andrem20/HazMapper/Documentation/Report_HazMapper_PT.pdf

HazMapper: Robo de Mapeamento de ˆ | Areas ´

# Perigosas

Projeto Integrador 2, 3º ano, Licenciatura em Engenharia Eletronica e Computadores ´ Universidade do Minho, Escola de Engenharia

Autores
Alvaro Silva, A104948 ´
Ana Cruz, A104950
Andre Martins, A104944 ´
Mariana Martins, A104961

Orientador
Prof. Adriano Tavares

Abstract—A crescente complexidade e os riscos inerentes a diversos ambientes industriais e de desastre sublinham a ne-
cessidade premente de soluçoes aut ˜ | onomas e seguras para a ´
monitorizaçao e mapeamento de ˜ | areas perigosas. A exposiç ´ | aõ
humana a atmosferas toxicas, temperaturas extremas ou ´ | areas de ´
difícil acesso representa um desafio significativo para a segurança
ocupacional e a resposta a emergencias. Neste contexto, a rob ˆ | otica ´
movel surge como uma tecnologia habilitadora, oferecendo a ´ capacidade de coletar dados críticos sem colocar operadores em risco direto.
Este relatorio apresenta o HazMapper, um rob ´ | o aut ˆ | onomo ´
concebido para a avaliaçao de ambientes de risco. O HazMapper ˜ integra um conjunto de sensores para medir parametros ambien- ˆ
tais cruciais, como a concentraçao de di ˜ | oxido de carbono (CO ´ | 2)
e a temperatura, transmitindo os dados em tempo real para uma
estaçao de controlo remota. Para garantir a navegaç ˜ | ao segura, ˜
o robo disp ˆ | oe tamb ˜ | em de sensores de deteç ´ | ao de obst ˜ | aculos, ´
que impedem o avanço em direçoes bloqueadas, permitindo a ˜
movimentaçao apenas nas ˜ | areas desimpedidas. No caso de n ´ | aõ
ser possível visualizar o ambiente diretamente, a presença de uma
camara ˆ | onboard possibilita o acompanhamento visual remoto do
que esta a acontecer. A arquitetura do sistema baseia-se num ´ microcontrolador STM32H755ZIQ para processamento central e controlo de movimento, com locomoçao omnidirecional garantida ˜ por quatro rodas e motores independentes. A comunicaçaõ
sem fios e assegurada por um m ´ | odulo ´ | ESP, que estabelece
uma ligaçao Bluetooth Low Energy (BLE) com uma aplicaç ˜ | aõ
Android desenvolvida especificamente para controlo intuitivo via joystick virtual. Adicionalmente, o robo incorpora um sistema de ˆ
mediçao cont ˜ | ínua da tensao da bateria, essencial para a gest ˜ | aõ
da autonomia e fiabilidade operacional. Foi implementado um RTOS no sistema de modo a o tornar mais eficiente e rapidamente responsivo.

AGRADECIMENTOS

Agradecemos ao Andre Costa e ´ | a professora Sofia Paiva por `
todo o apoio e orientaçao ao longo da realizaç ˜ | ao do projeto. ˜
Agradecemos tambem ao professor V ´ | ítor Silva pela confiança
no nosso potencial. Por fim — e nao menos importante — ˜ agradecemos ao professor Adriano Tavares pela confiança depositada e por ter aceite o nosso pedido para ser nosso orientador.
I. ANALISE ´
A. Diagrama de Use-Case
Anexo X-A Figura 20
B. Diagrama de Blocos

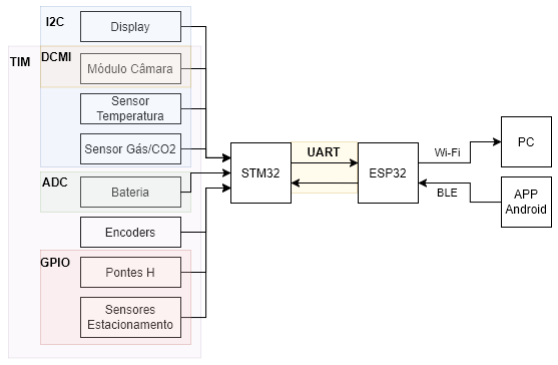
[picture p1: figure]

Fig. 1. Diagrama de Blocos Do Sistema

II. ARQUITETURA DE CONTROLO

A. Sistema de Movimentaçaõ
O HazMapper esta equipado com rodas omnidirecionais. ´ Estas possuem a capacidade de se movimentar livremente em qualquer direçao no plano horizontal, sem a necessidade de ˜ mudar a orientaçao do movimento. Este tipo de rodas oferece ˜ uma grande flexibilidade e agilidade, tornando-o muito util em ´
aplicaçoes que requerem movimentos precisos e r ˜ | apidos. ´
No nosso sistema, o movimento do robô e assegurado por ´ quatro motores, cada um acoplado a uma roda omnidirecional. O controlo individual de cada motor permite combinar os seus movimentos para produzir deslocamentos complexos, incluindo avanços, recuos e deslocamentos diagonais.
Cada motor e gerido de forma independente por uma ´ estrutura (motors_id) que agrega um conjunto de variaveis ´

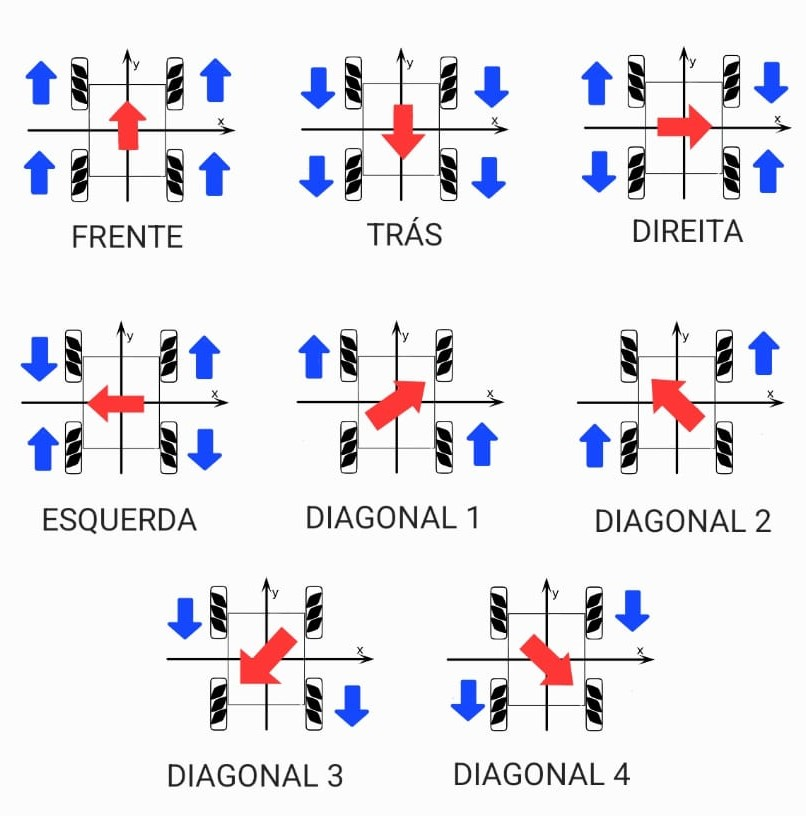
[picture p2: figure]

Fig. 2. Direçoes poss ˜ | íveis do robô

e estruturas necessarios para o seu controlo. As principais ´ características sao: ˜
- Estado: Indica se o motor esta parado (OFF), a andar ´ para a frente (FORWARD) ou para tras (REVERSE). ´
- Pinos | de | Direçao: ˜ | Dois | pinos | digitais
(FORWARD_DRIVE e REVERSE_DRIVE) controlam o
sentido de rotaçao. ˜
- PID Individual: Cada motor possui os seus proprios ´
parametros PID ( ˆ | Kp, Ki, Kd), permitindo afinaçao in- ˜
dependente.
- Variaveis de Execuç ´ | ao: ˜ | Incluem posiçao e velocidade ˜
(em rad/s e rpm), valor de PWM (modulaçao por largura ˜ de pulso) aplicado, e variaveis internas do controlo PID ´ (erro anterior, integral, etc.).
- Timer de PWM: Um TIM dedicado por motor e utilizado ´ para gerar o sinal PWM que regula a velocidade, que é aplicado ao pino ENABLE da ponte-H.
- Timer para Encoder: Cada motor utiliza um TIM em modo encoder (canais A e B) para leitura da posiçao e ˜ velocidade.
Esta estrutura modular permite o controlo preciso e independente de multiplos motores, facilitando a escalabilidade e ´ manutençao do sistema. ˜
A direçao de cada motor pode ser alterada ativando as ˜ entradas apropriadas do controlo da ponte H associada, como podemos ver nos Anexos X-B, permitindo movimento para a frente ou para tras, ou a paragem total. O verdadeiro desafio ´ no controlo de um robo com rodas omnidirecionais reside na ˆ coordenaçao dos quatro motores para alcançar o movimento ˜ global pretendido. Assim, o movimento do robô e gerido ´ com base numa LUT (Look-Up Table), onde estao definidos ˜ todos os movimentos possíveis (Figura 2) e a combinaçaõ correspondente de estados dos quatro motores, informaçao que ˜ foi retirada a partir da Figura 3. Esta LUT e consultada sempre ´ que e enviado um comando de movimento, permitindo uma ´
transiçao r ˜ | apida e organizada entre diferentes direç ´ | oes ˜
Quando um determinado comando e ativado, o sistema ´ atualiza os estados individuais dos motores de acordo com a entrada correspondente na LUT e posteriormente o PWM a

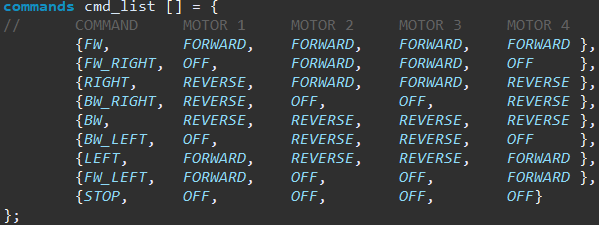
[picture p3: figure]

Fig. 3. LUT dos movimentos possíveis

eles aplicado. Estes estados sao traduzidos em sinais digitais ˜
que controlam os pinos de ativaçao das pontes H respons ˜ | aveis ´
por alimentar os motores.
O sistema e ainda capaz de ligar e desligar o rob ´ | o atrav ˆ | es de ´
um pino digital dedicado, garantindo que, quando desligado, todos os motores ficam inativos por segurança.
1) Algoritmo de Controlo de Velocidade – Controlo PID:
Para alem do controlo da direç ´ | ao, ˜ | e tamb ´ | em essencial que ´
todas as rodas girem a mesma velocidade, a fim de evitar `
desvios na trajetoria do rob ´ | o e assegurar uma locomoç ˆ | aõ
estavel e controlada.Para garantir o controlo preciso da ´ velocidade dos motores do robo, foi implementado um ˆ controlador PID (Proporcional-Integral-Derivativo) em malha fechada. Este tipo de controlo baseia-se na mediçao cont ˜ ínua da velocidade atual de cada motor e na comparaçao com um ˜
valor de referencia, designado por ˆ | setpoint. O objetivo do
controlador e minimizar o erro entre a velocidade medida ´ e a desejada, ajustando dinamicamente o sinal de controlo aplicado a cada motor.

A velocidade atual de cada motor e determinada utilizando ´ timers individuais dedicados a cada motor, configurados em modo encoder com suporte a codificaçao em quadratura. Cada ˜ motor possui um encoder incremental que gera dois sinais digitais, desfasados de 90°, permitindo contar pulsos e identificar a
direçao de rotaç ˜ | ao. Estes sinais s ˜ | ao ligados ˜ | as entradas de dois `
canais do timer. Esta funcionalidade permite que o contador interno do timer incremente ou decremente automaticamente
em funçao da do sentido de rotaç ˜ | ao e do n ˜ | umero de transiç ´ | oes ˜
dos sinais, sem necessidade de intervençao do processador, ˜ atualizando o valor do contador (TIMx_CNT) conforme o movimento do eixo, o que e crucial para o controlo bidire- ´ cional dos motores.
A variaçao de posiç ˜ | ao entre duas amostragens sucessivas ˜ | é
calculada subtraindo o valor anterior da posiçao ao valor atual. ˜
A posiçao atual do eixo do motor ˜ | e obtida atrav ´ | es da ´
leitura do valor do contador do timer, utilizando a macro
__HAL_TIM_GET_COUNTER(), e corresponde a posiç ` | aõ
absoluta acumulada desde o início do movimento. Com base
na posiçao acumulada, calcula-se a posiç ˜ | ao angular em graus, ˜
utilizando a seguinte expressao: ˜

θgraus =

posiçaõ × 360
PULSOS × 4 × SAMPLING TIME

(1)

A velocidade angular e calculada a partir da variaç ´ | aõ

do numero de pulsos entre duas mediç ´ | oes consecutivas. ˜
Assume-se um período de amostragem constante, e os fatores
numericos utilizados nas express ´ | oes abaixo incorporam esse ˜
intervalo de tempo. A formula utilizada para o c ´ | alculo da ´
velocidade em rad/s e:´

ω =

∆pulsos × 2π
PULSOS × 4 × SAMPLING TIME
(rad/s) | (2)
Cada transiçao nos sinais A e B (subida e descida) ˜ | | é
contabilizada, resultando numa multiplicaçao por quatro da ˜
resoluçao efetiva — da ˜ | í a utilizaçao de um fator de ˜ | 4 nos
calculos que envolvem o n ´ | umero de pulsos por volta ( ´ | pulses
per revolution, ou PPR). Estes calculos permitem obter, com ´
elevada precisao, a posiç ˜ | ao e a velocidade angular do motor, ˜
tirando partido da contagem automatica dos pulsos em modo ´ quadratura.
O erro de controlo e calculado como a diferença entre o ´ setpoint e a velocidade medida y:
| erro = setpoint − y | (3)

O controlador PID calcula o sinal de controlo como uma
combinaçao de tr ˜ | es componentes: ˆ
- Componente Proporcional (P): responde proporcionalmente ao erro atual, fornecendo uma correçao imediata; ˜
- Componente Integral (I): acumula o erro ao longo do tempo, eliminando desvios persistentes;
- Componente Derivativo (D): atua sobre a taxa de
variaçao do erro, ajudando a reduzir oscilaç ˜ | oes e ante- ˜
cipar tendencias. ˆ
Matematicamente, a saída do controlador e dada por: ´

output[k] = Kpe[k] + Ki

Pk
i=1

e[i]+e[i−1]
2

h + Kd

e[k]−e[k−1]
h
(4)
Na implementaçao pr ˜ | atica, este c ´ | alculo ´ | e discretizado e re- ´
alizado a cada período de amostragem. A saída do controlador
e utilizada para ajustar o ´ | duty cycle do sinal PWM aplicado a
cada motor, controlando assim a sua velocidade. Para garantir a segurança do sistema e respeitar os limites físicos, esta saída
e limitada entre 0 e a tens ´ | ao m ˜ | axima fornecida pela bateria. No ´
sistema implementado, a unica forma de controlar a velociade ´
e atrav ´ | es da definiç ´ | ao do ˜ | setpoint.
A eficacia deste tipo de controlo depende fortemente da ´
sintonizaçao adequada dos par ˜ | ametros do PID ˆ | , nomeada-
mente os ganhos proporcional (Kp), integral (Ki) e derivativo (Kd). Um ganho proporcional demasiado elevado pode induzir oscilaçoes; um ganho integral incorretamente calibrado pode ˜ provocar acumulaçao de erro e instabilidade; e um ganho ˜ derivativo excessivo pode amplificar o ruído proveniente da mediçao da velocidade. ˜
Uma analise mais detalhada do processo de determinaç ´ | aõ
dos parametros do PID ser ˆ | a apresentada na Subsecç ´ | ao VI, ˜
onde se descrevem os testes realizados e os criterios utilizados ´ para alcançar uma resposta estavel e eficaz. ´

Este controlo em malha fechada (Figura 21) permite uma
regulaçao robusta e eficiente da locomoç ˜ | ao do rob ˜ | o, mesmo ˆ
perante perturbaçoes externas, variaç ˜ | oes de carga ou assime- ˜
trias entre motores.
B. Interface de Comando via Aplicaçao M ˜ | ovel ´
A interaçao com o rob ˜ | o HazMapper ˆ | e realizada atrav ´ | es´
de uma aplicaçao m ˜ | ovel () desenvolvida para a plataforma ´
Android, utilizando a linguagem Kotlin. Esta aplicaçao serve ˜ como a interface principal de controlo e futura monitorizaçao, ˜ oferecendo uma experiencia de utilizador intuitiva para a ˆ
operaçao remota do rob ˜ | o.ˆ
1) Protocolo de Comunicaçao e Otimizaç ˜ | ao BLE: ˜ | A
comunicaçao com o m ˜ | odulo ´ | ESP do robô e realizada via ´
Bluetooth Low Energy (BLE), utilizando um protocolo
binario de dois bytes ´ | . O primeiro byte define o tipo de
comando (ex: 0x00 para ON/OFF, 0x01 para Direçao, ˜ | 0x02
para Velocidade), e o segundo byte especifica o valor associ-
ado. A estrutura completa desta gramatica de comunicaç ´ | aõ
e detalhada na Figura 4. Para otimizar o tr ´ | afego BLE, os ´
comandos de movimento sao enviados apenas quando os seus ˜ valores atuais diferem dos ultimos transmitidos. ´

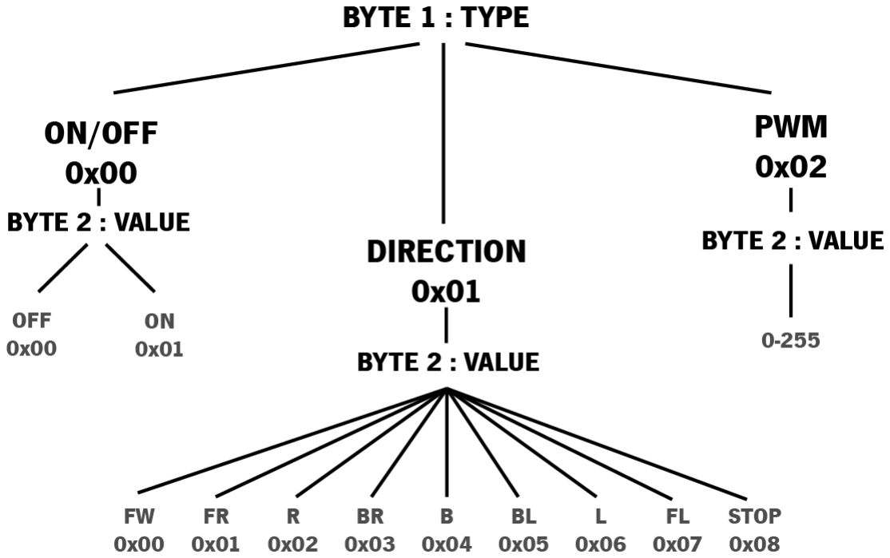
[picture p4: figure]

Fig. 4. Gramatica - comandos ´

2) Funcionalidades da Interface: A interface de utilizador inclui um Switch ON/OFF e um Joystick Virtual:
- O Switch ON/OFF controla o estado operacional do
robo. Ao ligar, envia um comando ( ˆ | 0x00, 0x01). Ao
desligar, alem do comando ( ´ | | 0x00, 0x00), a aplicaçaõ
envia comandos de STOP (0x01, 0x08) e velocidade zero (0x02, 0x00), garantindo a imobilizaçao imedi- ˜ ata.
- O Joystick Virtual (JoystickView) permite controlo omnidirecional, traduzindo a posiçao do ”handle” em co- ˜ mandos de direçao e velocidade, enviados a cada 500ms. ˜
– Direçao: ˜ | A posiçao angular ˜ | e quantificada em 8 ´
direçoes discretas (ex: ˜ | | FW, LEFT) ou STOP (na
deadzone central), enviadas como tipo 0x01.
– Velocidade: A distancia do ”handle” ao centro ˆ | e nor- ´
malizada de 0 (parado) a 255 (maximo), transmitida ´ como tipo 0x02. Uma histerese de 20 unidades é aplicada para estabilidade.

3) Conectividade: A aplicaçao gere as permiss ˜ | oes Blue- ˜
tooth necessarias (incluindo as espec ´ | | íficas do Android 12+) e
utiliza uma classe auxiliar (BLEManager) para a inicializaçaõ
e gestao da conex ˜ | ao BLE, assegurando uma comunicaç ˜ | aõ
fiavel com o rob ´ | o.ˆ

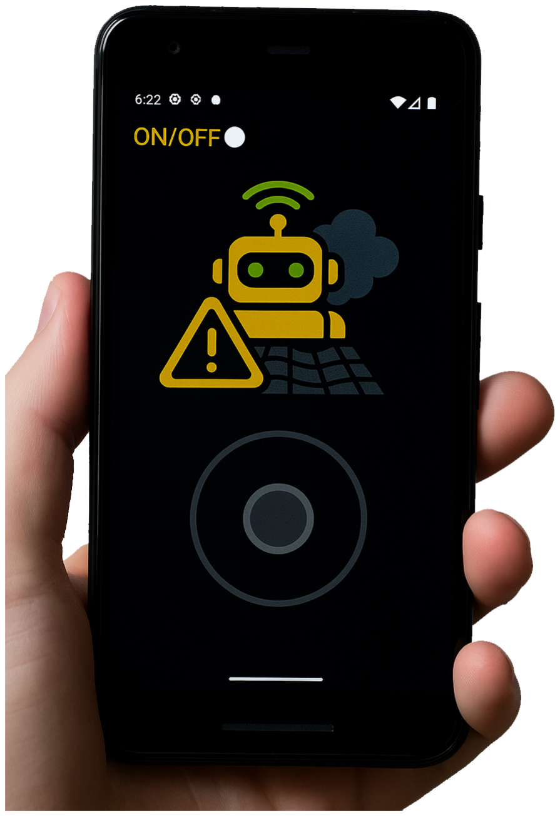
[picture p5: figure]

Fig. 5. App - Android

C. Comunicaçao Bluetooth via ˜ | ESP
Neste contexto, a ESP atua como um intermediario entre a ´
aplicaçao Android e a ˜ | STM32H755 utilizada, fazendo buffer-
ing dos dados recebidos via Bluetooth, transmitindo-os à STM atraves da UART. ´
Uma vez que e importante ter em consideraç ´ | ao os recursos ˜
do microcontrolador, foi implementado o Bluetooth Low Energy em vez do Bluetooth Classic, embora sejam introduzidas
restriçoes a n ˜ | ível do throughput. A implementaçao do BLE ˜
foi feita recorrendo ao NimBLE, uma stack Bluetooth 5.4 open-source da Apache. Na ESP implementou-se um servidor Generic Attribute Profile (GATT) com característica de escrita, permitindo ao cliente GATT (aplicaçao Android) ˜
escrever nesse topico. Entre os dois dispositivos existe ´ | pairing,
sem bonding. De modo a garantir que nao h ˜ | a perda de dados ´
foram realizadas as seguinte consideraçoes. ˜
- Maximo payload (ATT) ´ | com Data Length Extension
(DLE): 251B
- Isso equivale a: 251
2 = 125 frames de 2B por pacote BLE
- Considerando um maximo de 6 pacotes por evento de ´ conexao (limite da pilha NimBLE): ˜

6 × 125 = 750 frames por evento

- Com eventos a cada 15ms, temos aproximadamente: 1 s
15 ms

= 66,66 ≈ 66 eventos por segundo

- Frames por segundo:

66 × 750 = 49500 frames por segundo

- Cada frame com 2 bytes:

49500 × 2 = 99000 bytes/segundo = 792000 bps

- Portanto, para suportar essa taxa via UART, a baud rate mínima precisa de ser:

≥ 792000bps

Deste modo, a UART foi implementada com uma baud rate de 1 Mbps e com um buffer de 1024 bytes.

III. SISTEMA DE SENSORIZAÇ AO PARA ˜ | DETEÇ AO DE ˜

RISCOS

A. Sensores de deteçao de obst ˜ | aculos ´
Com o intuito de tornar o robo sens ˆ | ível ao meio que o
rodeia implementamos sensores de ultrassom para deteçao de ˜
obstaculos. Tendo em perspetiva a realizaç ´ | ao do mapeamento ˜
do meio pretendíamos ter sensores que conseguiam reconhecer
obstaculos existentes a uma dist ´ | ancia consider ˆ | avel (superior a ´
0.5m). Como tal, implementamos sensores de estacionamento
para automoveis no rob ´ | o.ˆ
Deste modo, foi necessario compreender o funcionamento ´ dos sensores e como eles reconheciam e interpretavam as
distancias detetadas. Estes s ˆ | ao acoplados a um componente ˜
central que suporta ate 8 sensores e que envia dados para um ´
pequeno display. Apos uma primeira observaç ´ | | ao, obteve-se a ˜
onda da Fig.6.

Fig. 6. Onda Total dos sensores de ultrassom

Apos alguns testes, apercebemo-nos que a onda enviada ´ se divide um 3 partes: Start Bit, Sync Bit e 8 bytes de
informaçao (1 byte por sensor). Para al ˜ | em disso, reparamos, ´
tambem, que o valor enviado nesses bytes era diretamente ´
proporcional a dist ` | ancia detetada em cent ˆ | ímetros, com uma
razao de proporcionalidade de 10, tal como apresenta a tabela ˜ I.
Distancia Detetada ˆ | Valor Enviado (decimal)
d < 0.3 m | 0
0.3 m ≤ d < 0.4 m | 3
0.4 m ≤ d < 0.5 m | 4
0.5 m ≤ d < 0.6 m | 5
0.6 m ≤ d < 0.7 m | 6
0.7 m ≤ d < 0.8 m | 7
0.8 m ≤ d < 0.9 m | 8
0.9 m ≤ d < 1 m | 9
1.0 m ≤ d < 1.1 m | 10
1.1 m ≤ d < 1.2 m | 11
1.2 m ≤ d < 1.3 m | 12
1.3 m ≤ d < 1.4 m | 13
1.4 m ≤ d < 1.5 m | 14
d ≥ 1.5 m | 255
TABLE I
DISTANCIA DETETADA E RESPETIVO VALOR ENVIADO ˆ

Uma analise mais detalhada ao funcionamento das ondas ´ dos sensores encontra-se no anexo ??.

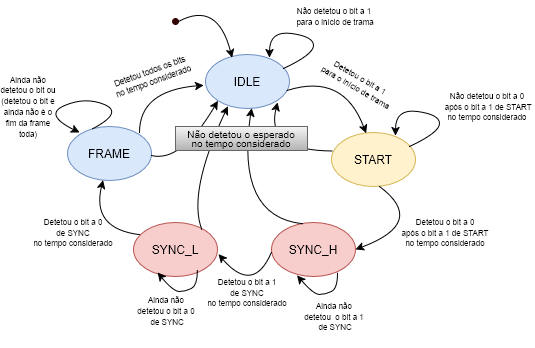
[picture p6: figure]

Fig. 7. Maquina de Estados implementada para os Sensores de Obst ´ | aculos ´

Conhecendo o princípio de funcionamento dos sensores,
implementamos um m ´ | etodo de descodificaç ´ | ao baseado na ˜
amostragem do sinal enviado, com um período de aquisiçaõ de 10 µs. O processo de descodificaçao e tratamento da trama ˜
recebida e implementado atrav ´ | es de uma m ´ | aquina de estados ´
finita (FSM), conforme ilustrado na Figura 7. Este sistema realiza a leitura sequencial dos bits recebidos, a validaçao por ˜
comparaçao com os padr ˜ | oes esperados para cada secç ˜ | ao da ˜
trama e o tratamento adequado conforme o estado atual do
processo. A cada condiçao da FSM acrescenta o a verificaç ˜ | aõ
de se foram lidos valores ou nao. Caso n ˜ | ao tenham sido, volta ˜
novamente para o estado onde se encontra.
B. Camara de Monitorizaç ˆ | ao para Zonas de Risco ˜
De forma a tornar o robo aplic ˆ | avel ´ | a situaç ` | ao apresentada, ˜
alem de dispor de controlo remoto para monitorizar zonas ´ perigosas, foi essencial dota-lo com a capacidade de trans- ´
missao de v ˜ | ídeo em tempo real, sendo assim implementado
o modulo OV7670, uma c ´ | amara que utiliza o protocolo ˆ
SCCB, compatível com I2C, para comunicar com a STM32.
Esta comunicaçaõ e realizada de forma ass ´ | íncrona, atraves´
de um barramento diferente dos outros sensores, pois neste
modulo n ´ | ao se encontram integradas as resist ˜ | encias ˆ | pull-up
características do barramento I2C.
A STM32 configura inicialmente a camara para capturar ˆ imagens com resoluçao QVGA (320×240 pixels), em modo ˜ RGB565 e vídeo progressivo. O funcionamento da camara ˆ assenta em sinais como o MCLK (clock mestre fornecido pela STM32 a c ` amara- 16 MHz), PCLK (clock de pixel ˆ que sincroniza a saída de dados), HSYNC (sincronizaçaõ horizontal que indica o início e fim de cada linha) e VSYNC
(sincronizaçao vertical que indica o in ˜ | ício e fim de cada
frame).
Cada frame contem 76 800 pixels, e com 16 bits por pixel, ´ totaliza 153 600 bytes por frame. Para captar estes dados, o microcontrolador STM32 recorre ao periferico DCMI (Digital ´ Camera Memory Interface), que recebe os dados da camara em ˆ modo de 8 bits por ciclo de PCLK. O DCMI esta configurado ´ para trabalhar em conjunto com o DMA, que transfere os dados recebidos diretamente para um buffer na memoria RAM, ´ evitando a intervençao cont ˜ ínua do CPU. Apos a captura de ´
um frame completo (HAL_DCMI_FrameEventCallback),
o conteudo do buffer ´ | e transmitido pela UART3 configurada ´
a uma baud rate elevada (2 Mbps), para permitir uma trans-
ferencia r ˆ | apida dos dados para o computador. A transmiss ´ | aõ
e realizada tamb ´ | em por DMA, assegurando que o microcon- ´
trolador nao fica bloqueado e pode continuar a capturar novos ˜ frames ou executar outras tarefas.
No computador, um script em Pyhton recolhe os dados
enviados pela UART, reconstroi os frames a partir da sequ ´ | encia ˆ
de bytes e exibe o vídeo capturado em tempo real, permitindo a visualizaçao do ambiente envolvente. ˜
Devido as limitaç ` | oes da aplicaç ˜ | ao embebida utilizada no ˜
que diz respeito ao suporte de perifericos multim ´ | edia, n ´ | aõ
foi possível obter um streaming de vídeo contínuo. Como alternativa, conseguimos apenas visualizar imagens de forma intervalada, ainda que com um atraso reduzido. A limitaçao da ˜ plataforma STM32, especialmente no processamento e trans-
missao eficiente de dados de imagem, impede a implementaç ˜ | aõ
de uma camara verdadeiramente ˆ | on board, obrigando a sua `
ligaçao ao computador via cabo USB. ˜
Apesar da adoçao de mecanismos para melhorar o desem- ˜ penho, como o aumento da baud rate e a utilizaçao de ˜ DMA (Direct Memory Access), o sistema continua sem capacidade
suficiente para suportar uma transmissao fluida. Consider ˜ | amos ´
ainda a implementaçao de compress ˜ | ao JPEG para comprimir ˜
os dados transferidos, mas essa abordagem, embora beneficie a largura de banda, nao resolve por completo o problema da ˜ velocidade de aquisiçao e envio. ˜
Adicionalmente, o uso do modo RGB565, embora eficiente em termos de profundidade de cor e compatibilidade com a maioria dos sensores, requer dois ciclos de clock para a transmissao de cada pixel, o que contribui ainda mais para a ˜ latencia do sistema e agrava a dificuldade de alcançar uma ˆ taxa de atualizaçao pr ˜ oxima do tempo real. ´
C. Monitorizaçao da Temperatura ˜
A monitorizaçao da temperatura do meio ambiente ˜ | e cr ´ | ítico
para a avaliaçao de riscos do HazMapper. Para isso, utilizamos ˜ um sensor de temperatura digital (HDC1080) com interface
I2C. A comunicaçaõ | e gerenciada pela ´ | STM32 atraves de ´
uma Maquina de Estados Finita (FSM - representada na Fig.8) ´ assíncrona, garantindo que as operaçoes de leitura do sensor ˜
nao bloqueiem outras funcionalidades do rob ˜ | o.ˆ
A FSM e composta por quatro estados principais que ´
coordenam a aquisiçao de dados de temperatura de forma n ˜ | ao- ˜
bloqueante:
- SENSOR STATE IDLE: Estado inicial, onde o sistema aguarda um sinal para iniciar uma nova mediçao. ˜
- SENSOR STATE TEMP TX: | Transmite-se | o
comando de leitura de temperatura ao HDC1080
via I2C.A transiçao para o pr ˜ | oximo estado ocorre ap ´ | os´
a conclusao da transmiss ˜ | ao. ˜

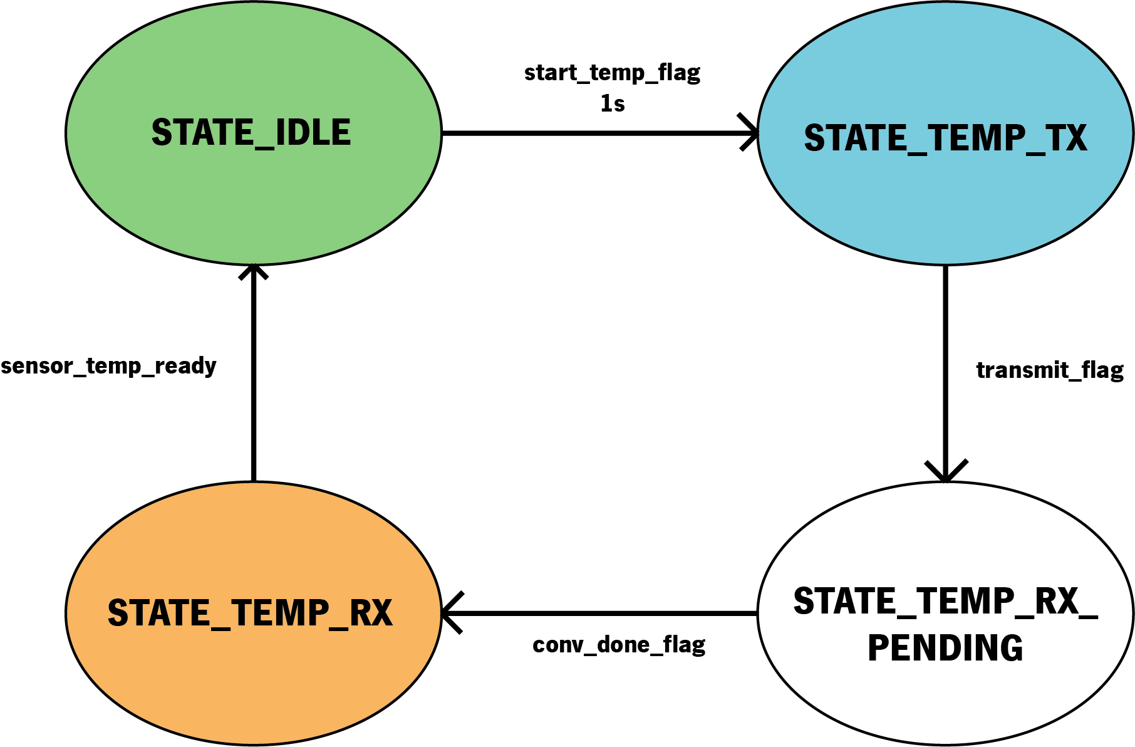
[picture p7: figure]

Fig. 8. Maquina de Estados - leitura do sensor HDC1080 ´

- SENSOR STATE TEMP RX PENDING: | Apos | a ´
transmissao, o sistema aguarda o tempo de convers ˜ | aõ
interna do sensor (15ms para o HDC1080).
- SENSOR STATE TEMP RX: Os 2 bytes de dados de temperatura sao lidos do HDC1080 via I2C Uma vez ˜ recebidos os dados brutos sao processados e convertidos ˜ para o valor em Celsius utilizando a formula: ´
Tcelsius = ((raw/65536.0f) ∗ 165.0) − 40.0.
D. Monitorizaçao dos n ˜ | íveis de gas´
A monitorizaçao dos gases em redor do HazMapper ˜ | é
uma componente essencial para garantir uma vigilancia eficaz ˆ das areas de risco. Para tal, foi integrado o sensor digital ´
CCS811, responsavel por medir a concentraç ´ | ao de di ˜ | oxido ´
de carbono equivalente (eCO) e compostos organicos vol ˆ | ateis ´
totais (TVOC) atraves de comunicaç ´ | ao I2C. ˜
A estrutura de programaçao deste sensor segue o mesmo ˜ princípio aplicado ao sensor de temperatura: foi implementada
uma maquina de estados ass ´ | íncrona.
Num primeiro momento, o sensor e configurado atrav ´ | es da ´
funçaõ ccs811_init na qual configuramos o pino WAKE de modo a que esteja a low para aceitar comandos I2C e configuramos a transiçao do boot mode para o application ˜ mode. Para isso, e enviado um comando especial, o byte 0xF4, ´ designado pelo fabricante como APP_START. Este comando
nao corresponde ˜ | a escrita num registo espec ` | ífico, mas sim a
uma instruçao direta que ordena ao CCS811 que inicialize o ˜ firmware interno de mediçao de gases, ficando pronto para ˜
fornecer dados de qualidade do ar. Apos esta inicializaç ´ | ao, ˜
o registo de modo de funcionamento MEAS_MODE e tamb ´ | em´
configurado para definir a frequencia de amostragem e eventu- ˆ
ais interrupçoes. A partir da ˜ | í, toda a leitura de dados e gerida ´
pela maquina de estados, que coordena a sequ ´ | encia ”pedido ˆ
de leitura → espera de conversaõ | → receçao dos dados”, ˜
garantindo que a comunicaçao I2C decorre de forma fi ˜ | avel ´
e sem conflitos.
Apos esta inicializaç ´ | ao, aproveitou-se a configuraç ˜ | ao do ˜
temporizador ja utilizada para o sensor de temperatura, apli- ´ cando uma estrutura semelhante para que o CCS811 tambem´
realizasse mediçoes com uma frequ ˜ | encia de 1 segundo. ˆ
Atraves da funç ´ | aõ start_read, e enviado o endereço do ´
registo 0x02, que corresponde ao bloco de dados de mediçao. ˜ Em seguida, o receive armazena o conteudo num array de 8 ´

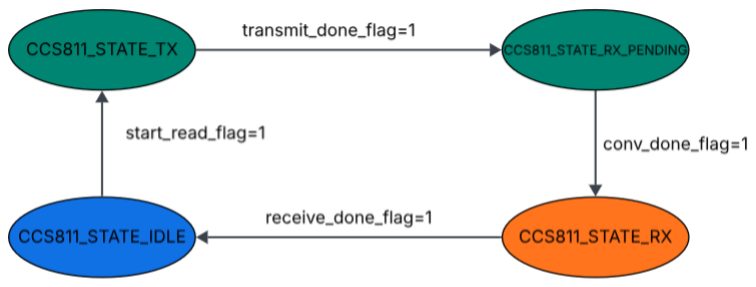
[picture p8: figure]

Fig. 9. Maquina de estados- leitura do sensor CCS811 ´

bytes, onde os primeiros dois bytes contem o valor de CO ˆ equivalente (eCO), o terceiro e quarto bytes contem o valor ˆ de TVOC e os restantes incluem informaçao adicional, como ˜ o estado do registo STATUS.
A maquina de estados ´ | e composta por quatro estados ´
principais:
- CCS811 STATE IDLE: Estado inicial, no qual o sistema permanece em espera e, ciclicamente, verifica se é
necessario iniciar a leitura do registo ´ | 0x02 do sensor.
- CCS811 STATE TX: Estado de transmissao, onde o ˜
endereço do registo 0x02 e enviado ao sensor. Ap ´ | os´
esta transmissao, ˜ | e introduzido um tempo de espera de ´
aproximadamente 5 ms para garantir a disponibilidade dos dados.
- CCS811 STATE RX PENDING: Decorrido o tempo de espera, o sistema inicia a receçao dos 8 bytes de dados ˜ provenientes do registo 0x02. A informaçao recebida ˜ inclui, em particular, os valores de CO2 e TVOC.
- CCS811 STATE RX: Estado final da leitura, em que os 4 bytes de interesse (do CO2 e TVOC) ja foram ´ processados. Neste ponto, e ativada uma flag para indicar ´ que a receçao terminou com sucesso. ˜
Apos esta etapa, foi implementado um c ´ | odigo para controlar ´
um display LCD 1602A, com o objetivo de apresentar, em tempo real, os valores medidos dos gases: o CO em ppm e o TVOC em ppb. Desta forma, tornou-se possível visualizar diretamente, no display, os dados adquiridos pelo sensor CCS811.
E. Monitorizaçao da bateria ˜
A constante avaliaçao da tens ˜ | ao da bateria ˜ | e crucial para a ´
autonomia e gestao de energia do rob ˜ | o, permitindo o ajuste ˆ
do controlo de velocidade dos motores e alertas sobre níveis
críticos. Este processo e implementado utilizando o ´ | Conversor
Analogico-Digital (ADC) ´ | da propria ´ | STM32.
A tensao da bateria ˜ | e, primeiramente, reduzida por um ´
divisor de resistivo (R1 = 50kΩ, R2 = 10kΩ) para ser compatível com a faixa de entrada do ADC (suporta ate 3.3V). ´ O valor digital de 12 bits (raw value) obtido pelo ADC é
entao convertido para Volts (V) atrav ˜ | es da seguinte f ´ | ormula: ´

VBAT = raw value ×

VREF
ADCMAX

×

R1 + R2
R2

(5)

Onde VREF = 2.0 V e ADCMAX = 4095.

A aquisiçao dos dados do ADC ˜ | e realizada de forma ´
periodica a cada 1ms, com a convers ´ | ao iniciada via ˜ | Direct
Memory Access (DMA) (HAL_ADC_Start_DMA), minimizando a carga no CPU. A funçaõ Battery_process() interpreta a leitura da tensao ( ˜ vbat) e, com base num limiar de 11.0V, ativa LEDs indicadores (laranja para bateria OK, vermelho para bateria crítica), alertando o utilizador sobre o estado de carga.
F. Transmissao de Dados de Sensores via Wi-Fi com ˜ | ESP
A transmissao dos dados via Wi-Fi com a ˜ | ESP visa con-
ferir uma monitorizaçao cuidada do sistema, bem como do ˜ ambiente que o rodeia.
Para tal, configurou-se a ESP como Access Point (AP). Um dispositivo (o computador, por exemplo) conecta-se a essa rede Wi-Fi e, apos estar corretamente configurado. pode ´
receber/enviar dados a partir dessa conexao, quer atrav ˜ | es´
de um servidor HTTP (Modelo OSI: HTPP - camada de Aplicaçao, baseado em TCP/IP - camada de transporte), quer ˜
atraves de sockets UDP. Como o envio das dados ´ | e frequente, ´
a perda de algum dado naõ e necessariamente cr ´ | ítica, e, como
tal, recorremos ao envio de sockets UDP para os dados dos
sensores. Para alem disso, por n ´ | ao requerer confirmaç ˜ | ao, o ˜
UDP introduz menor overhead.
IV. INTEGRAÇ AO DO ˜ | RTOS

A implementaçao de um Sistema Operativo de Tempo Real ˜ (RTOS) no sistema visou otimizar a eficiencia computacional ˆ e o desempenho global, assegurando:
- Comportamento determinístico;
- Baixa latencia ˆ ;
- Jitter controlado.
Para tal, adotou-se o FreeRTOS, aproveitando os seus mecanismos avançados de:
- Comunicaçao entre processos (IPC); ˜
- Escalonamento de tarefas por prioridades;
- Gestao de mem ˜ | oria est ´ | atica. ´
V. ESTRUTURA DE HARDWARE INTEGRADO EM PCB
Para este projeto, decidimos desenvolver uma PCB personalizada com o objetivo de minimizar a utilizaçao de fios e ˜
reduzir interferencias eletromagn ˆ | eticas. A PCB foi projetada ´
em duas secçoes principais: uma de pot ˜ | encia e outra de sinais ˆ
digitais.
Entre estas duas zonas, foi criada uma area de isolamento, ´ onde se encontram os isoladores capacitivos, como podemos
ver na Figura 10. Estes sao respons ˜ | aveis por garantir o ´
isolamento galvanico entre os sinais de pot ˆ | encia e os sinais ˆ
digitais, especialmente nos casos em que sinais de potencia ˆ precisam ser lidos pela STM32 ou vice-versa. Para o canal ADC, foi utilizado um isolador analogico juntamente com um ´ díodo Zener de 3,3V para proteger o pino da STM32 contra sobretensoes. ˜
De forma a garantir o isolamento total entre os domínios de
potencia e digital, tamb ˆ | em foi utilizado um conversor DC-DC ´
isolado e regulado para alimentar a STM32. Certificamo-nos ´

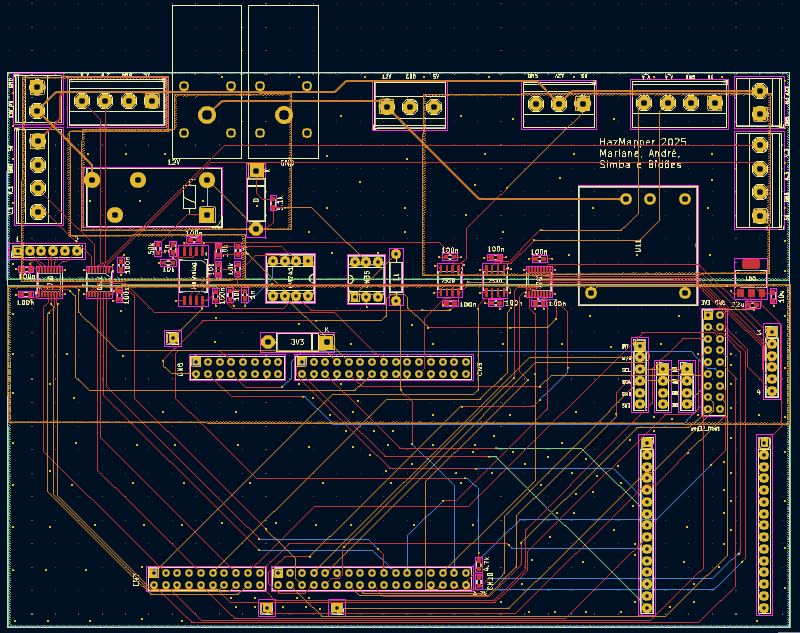
[picture p9: figure]

Fig. 10. Layout da PCB

ainda de que todos os sinais partilhados entre os dois domínios estavam devidamente isolados. Como os pinos da STM32 fornecem, em media, apenas 25 mA de corrente, decidiu-se ´ utilizar um regulador LDO (de 5 V para 3,3 V) dedicado. Esta soluçao garante que os sensores e demais componentes que ˜
necessitam de alimentaçao a 3,3 V n ˜ | ao sejam alimentados ˜
diretamente pela STM32, a qual nao conseguiria fornecer ˜ corrente suficiente de forma segura e estavel. ´
Foi tambem implementado um mecanismo de proteç ´ | | ao no ˜
circuito de alimentaçao. Assim que o bot ˜ | ao de ON/OFF ˜ | e pres- ´
sionado, um relé e ativado para ligar a alimentaç ´ | ao de pot ˜ | encia. ˆ
O sinal de controlo enviado pela STM32 para o rele passa ´ por um optoacoplador, garantindo o isolamento eletrico entre ´ o microcontrolador e a carga de potencia. Adicionalmente, foi ˆ colocado um díodo de flyback (freewheeling) paralelo a bobina `
do rele para proteger o circuito contra picos de tens ´ | ao gerados ˜
pela comutaçao do rel ˜ | e, como podemos ver na Figura 24. ´
Na Figura 10 e poss ´ | ível observar os suportes dedicados para
a STM32, que ficara montada de forma invertida, conforme ´
mostrado Figura 11. Tambem existem suportes para a ´ | | ESP,
entradas para os encoders dos motores, ligaçoes para as ˜
alimentaçoes externas e conex ˜ | oes para os sensores. ˜

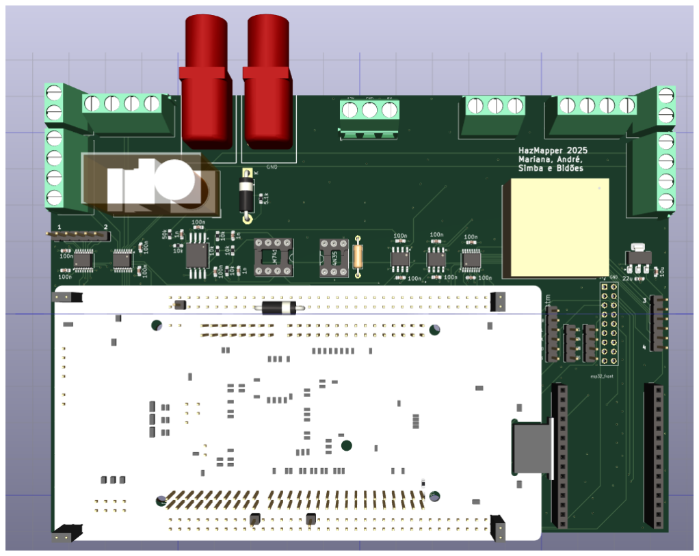
[picture p10: figure]

Fig. 11. Visualizaçao 3D da PCB ˜

A PCB foi construída com quatro layers na seguinte
disposiçao: sinal, GND, sinal, GND. Esta configuraç ˜ | ao ajuda ˜
a garantir uma boa integridade dos sinais e minimizar inter-
ferencias. Foi tamb ˆ | em realizado stitching de vias ao longo ´

da placa, especialmente em zonas críticas e onde circulam sinais de alta frequencia (na ordem dos MHz), como o ˆ
MCLK e o PCLK da camara. Nessas regi ˆ | oes, foi adicionado ˜
extra stitching para melhorar o plano de retorno e reduzir ruído. Os sinais digitais de comunicaçao foram organizados na ˜ primeira camada da PCB, e foram criados planos dedicados para otimizar o roteamento e reduzir interferencias entre os ˆ circuitos.
A conceçao desta PCB permitiu integrar de forma segura ˜ e eficiente os circuitos de potencia e controlo, garantindo ˆ
isolamento adequado, proteçao contra ru ˜ | ídos e picos de tensao, ˜
e um layout otimizado para desempenho eletromagnetico. O ´ uso de componentes SMD e uma estrutura de quatro layers contribuiu para a miniaturizaçao e estabilidade do sistema. ˜
VI. TESTES E VALIDAÇ AO DOS ˜ | MODULOS ´
A. Controlo via Teclado para Direçao e PWM ˜

Inicialmente, para testar se a estrutura mencionada no Capítulo II-A funcionava corretamente — ou seja, se as direçoes e a velocidade realmente alteravam conforme esper- ˜ ado — decidimos implementar o controlo por meio do teclado do computador, via UART3.
Para isso, definimos dois arrays:

char* valid_movements[NUM_MOVES] = {"W", "E", "D", "C", "X", "Z", "A", "Q", "S"};

const float valid_pwm[] = {0, 10, 20,
30, 40, 50, 60, 70, 80, 90, 100};

Cada letra correspondia a um comando de movimento específico, fazendo com que as rodas girassem nas direçoes ˜ previstas. Ja os n ´ umeros pressionados no teclado determi- ´ navam o duty cycle aplicado pelo controlador PWM, usando o valor correspondente no array valid_pwm, que era passado para a funçaõ update_pwm.
Dessa forma, pudemos comprovar que o robo alterava o seu ˆ comportamento de movimento de acordo com os comandos enviados, validando uma primeira fase do funcionamento do sistema de controlo.
B. Encoders

Para testar se os encoders estavam a funcionar corretamente,
observamos os sinais A e B num oscilosc ´ | opio. Confirm ´ | amos ´
que os sinais estavam desfasados em 90° (Figura 12), característica essencial da codificaçao em quadratura. ˜
Alem disso, para determinar o sentido positivo da veloci- ´
dade, analisamos a relaç ´ | ao entre as transiç ˜ | oes dos sinais. No ˜
nosso caso, o robo desloca-se para a frente quando o motor ˆ roda no sentido anti-horario. Assim, quando o sinal B faz a ´
sua transiçao, se o sinal A estiver em n ˜ | ível logico alto (1), o ´
motor esta a rodar no sentido anti-hor ´ | ario (movimento para a ´
frente). Por outro lado, se o sinal A estiver em nível logico ´ baixo (0) nesse momento, o motor esta a rodar no sentido ´
horario (movimento para tr ´ | as). ´

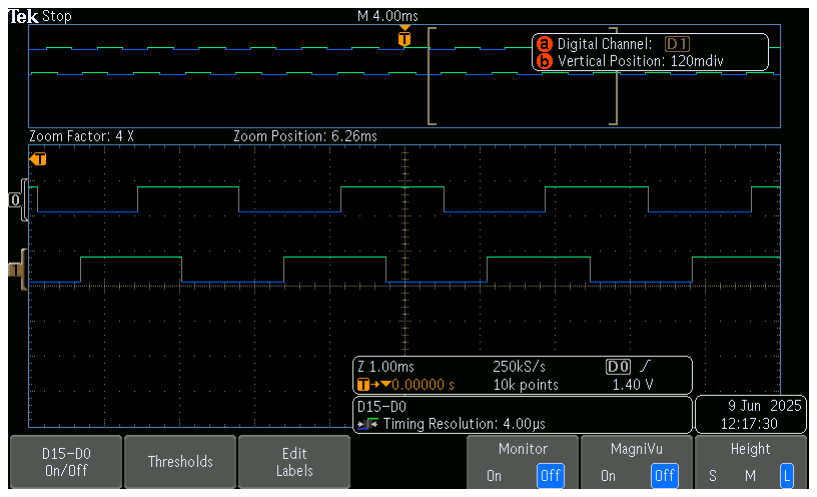
[picture p11: figure]

Fig. 12. Sinais A (1) e B(0) do Encoder em Quadratura

C. Calculo e ajuste dos par ´ | ametros PID ˆ
Para implementar o controlo PID, primeiro foi necessario ´ determinar os parametros de cada motor, seguindo o proced- ˆ imento igual ao realizado no Guia 2 de PI2. Utilizamos a ´
mesma equaçao de estados (Equaç ˜ | ao 8) e realiz ˜ | amos os testes ´
sob as mesmas condiçoes para todos os motores: aplic ˜ | amos ´
uma tensao constante ao motor, com ua ˜ | = 9,2 V e PWM =
76,7%. Assim, medimos a corrente e a velocidade de rotaçaõ correspondentes, como podemos observar na Tabela II.
Os outros parametros do modelo foram calculados com base ˆ
nas expressoes fornecidas no Guia2, mas em espec ˜ | ífico para
os nossos motores, nomeadamente: o momento de inercia do ´
sistema mecanico (Equaç ˆ | ao 9), o coeficiente de fricç ˜ | ao linear ˜
(Equaçao 11), a constante eletromec ˜ | anica (Equaç ˆ | ao 10) e a ˜
resistencia el ˆ | etrica do motor. Os resultados encontram-se na ´
Tabela II.
De seguida, procedemos a definiç ` | ao do per ˜ | íodo de
amostragem. Para tal, utilizamos um script em MATLAB que ´ calcula o período de amostragem ideal. Este deve ser suficientemente pequeno para que o controlador consiga detetar,
de forma significativa, a presença da dinamica mais r ˆ | apida do ´
sistema, associada a funç ` | ao de transfer ˜ | encia relacionada com ˆ
o polo dominante.
Este polo e aquele com maior m ´ | odulo, correspondendo ´
a maior frequ ` | encia de corte na resposta em frequ ˆ | encia do ˆ
sistema. Conforme ilustrado na Figura 13, adotamos a seguinte ´
relaçao para o per ˜ | íodo de amostragem:

Ts =

1
8 × |polo|

(6)

Como todos os polos dos motores analisados apresentaram valores muito proximos, e para simplificar o desenvolvi- ´
mento do codigo, opt ´ | amos por utilizar o mesmo per ´ | íodo de
amostragem para todos os motores.
Com o período de amostragem definido, procedemos ao
calculo dos par ´ | ametros do controlador PID usando o “PID ˆ
Tuner”. A Figura 14 exemplifica como a implementaçao do ˜ controlo PID permite ao sistema atingir uma resposta mais
rapida e est ´ | avel. ´
Apos calcular os par ´ | ametros do controlador PID para cada ˆ
motor (Tabela II), realizamos testes pr ´ | aticos. Para melhorar ´

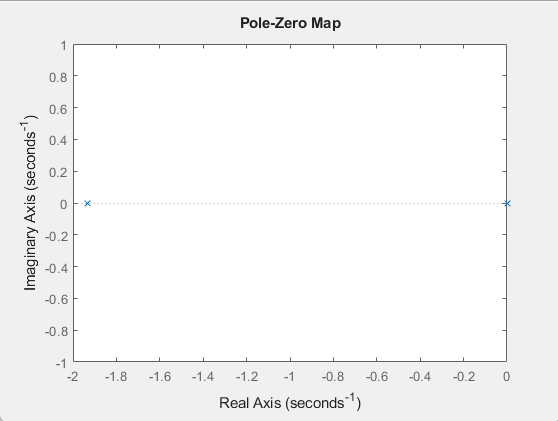
[picture p12: figure]

Fig. 13. Polos do sistema ´

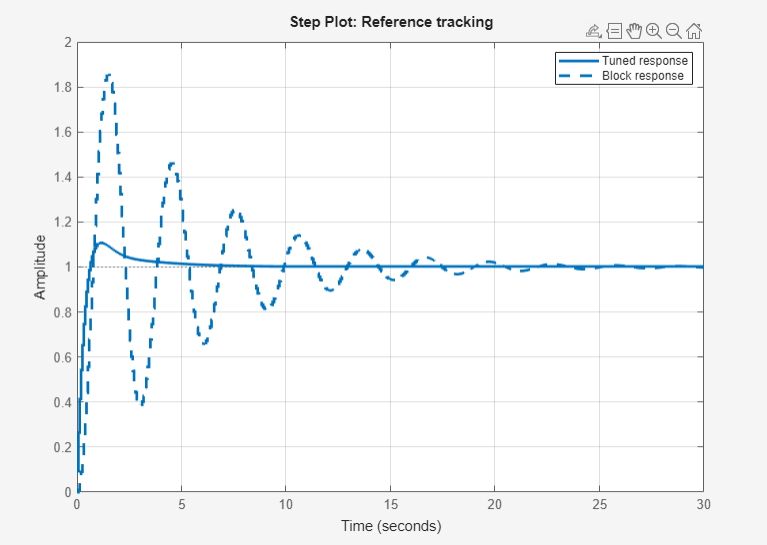
[picture p13: figure]

Fig. 14. Sistema com controlo vs sem controlo PID

a qualidade da resposta, foi necessario adicionar um filtro ´ para eliminar ruídos e perturbaçoes. No entanto, mesmo as- ˜ sim, a resposta apresentava um overshoot consideravel. Para ´ corrigir este comportamento, fomos ajustando manualmente os
parametros do PID, com destaque para o ganho integral ( ˆ | KI ),
que foi progressivamente reduzido para diminuir o overshoot. Em alguns casos, aumentamos ligeiramente o ganho deriva- ´ tivo (KD) para melhorar a resposta transitoria e aumentar a ´ estabilidade do sistema, pois este ganho ajuda a antecipar as
variaçoes da resposta e a amortecer oscilaç ˜ | oes. ˜
De forma geral, o ajuste dos parametros PID foi feito ˆ seguindo estes passos:
1) Ajustar KP para obter uma resposta rapida, mas sem ´ causar instabilidade.
2) Reduzir KI para evitar excesso de overshoot e reduzir o erro e o tempo de estabilizaçao. ˜
3) Incrementar KD para suavizar a resposta e minimizar
oscilaçoes na fase transit ˜ | oria. ´
Este processo foi iterativo e necessario para garantir um ´ controlo eficiente e robusto para cada motor testado.
D. ADC
Para testar o ADC, começamos por utilizar um po- ´
tenciometro, que apenas permitia uma tens ´ | ao m ˜ | axima de ´
3,3 V, garantindo assim a segurança do pino da STM32 e confirmando o funcionamento correto do conversor analogico- ´
| Motor 1 | Motor 2 | Motor 3 | Motor 4
ia (A) | 0.16 | 0.15 | 0.14 | 0.21
w (rad/s) | 25.9 | 27.2 | 27.2 | 26.3
J (kg/m² ) | 0.07 | 0.07 | 0.07 | 0.07
Bf (N/(m/s)) | 0.0019 | 0.0016 | 0.0015 | 0.0025
Km (N/A) | 0.306 | 0.293 | 0.292 | 0.317
R (ohm) | 8.06 | 8.13 | 9.03 | 4.15
Kp (teorico) ´ | 1.8 | 1.67 | 1.51 | 0.9
Ki (teorico) ´ | 0.65 | 0.51 | 0.41 | 0.3
Kd (teorico) ´ | 0.72 | 0.63 | 0.63 | 0.57
Filtro | 0.67 | 0.67 | 0.67 | 0.67
Sampling time (ms) | 65 | 65 | 65 | 65
TABLE II
PARAMETROS DOS MOTORES E CONTROLADORES ˆ
digital. Apos esta verificaç ´ | ao inicial, avanç ˜ | amos para o dimen- ´
sionamento do circuito de mediçao da bateria. ˜
E. Modulo OV7670- C ´ | amara ˆ
Para validar o correto funcionamento da camara OV7670, ˆ
começamos por testar a comunicaç ´ | ao I2C. O datasheet forne- ˜
cia os endereços de escrita (0x42) e leitura (0x43) do dispositivo, assim como os endereços internos dos registos. Como se pode observar na Figura 25 capturada no osciloscopio, foi ´ possível realizar com sucesso uma escrita, seguida de uma leitura do registo 0x0B, correspondente ao identificador do dispositivo. O valor lido foi 0x73, o que confirma que a
comunicaçao est ˜ | a a funcionar corretamente e que a c ´ | amara ˆ
foi devidamente identificada.
Na Figura 26, e poss ´ | ível observar o sinal PCLK, cuja
frequencia est ˆ | a aproximadamente nos 16, correspondendo ´ | à
frequencia do sinal ˆ | MCLK fornecido a c ` amara. O ˆ | PCLK
define o ritmo a que os 8bits de dados de cada pixel saõ disponibilizados nas linhas de dados (D[7:0]), sendo fundamental para a sincronizaçao da leitura da imagem. ˜

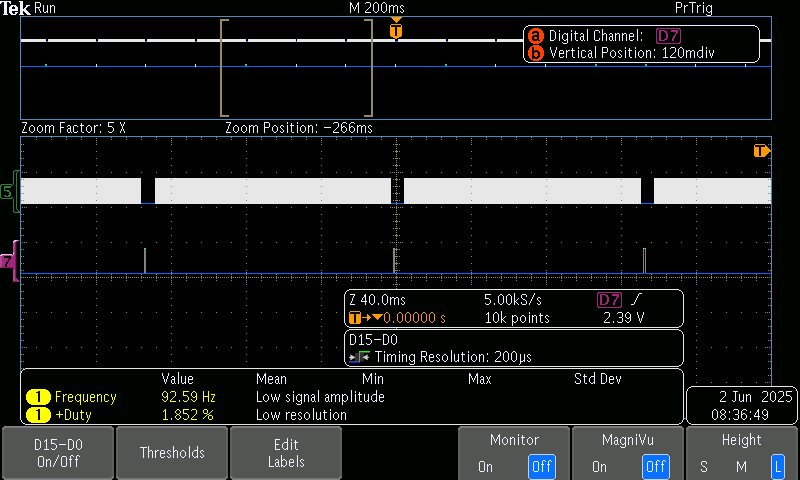
[picture p14: figure]

Fig. 15. Sinais de sincronizaçao da OV7670 - HSYNC (5) e VSYNC (7) ˜

Na Figura 15, e poss ´ ível identificar os sinais HSYNC e VSYNC. O VSYNC ocorre com uma frequencia signi- ˆ ficativamente menor, pois indica o fim de cada frame completo, enquanto o HSYNC sinaliza o início de cada linha
da imagem. Devido a escala da captura, o ` | HSYNC naõ
e claramente vis ´ | ível, ja que ocorre a cada 240 linhas (em ´
resoluçao 320 x 240), tornando-se demasiado frequente para ˜ ser distinguido nessa visualizaçao. Assim, comprovou-se o ˜
correto funcionamento da camara, validando a comunicaç ˆ | aõ

e os sinais essenciais. Com esta etapa concluída, foi entaõ possível avançar para a implementaçao da recolha de dados ˜ de imagem.

F. BLE ESP
Para validar o funcionamento do BLE na ESP recorremos
a aplicaç ` | ao nRF Connect. Aqui conseguimos verificar se a ˜
ESP esta detet ´ | avel (Fig.16) e se o t ´ | opico GATT com o ´
UUID personalizado, designado para serviço de escrita aparece disponível (Fig. 17).

Fig. 16. ESP com BLE detetavel) ´

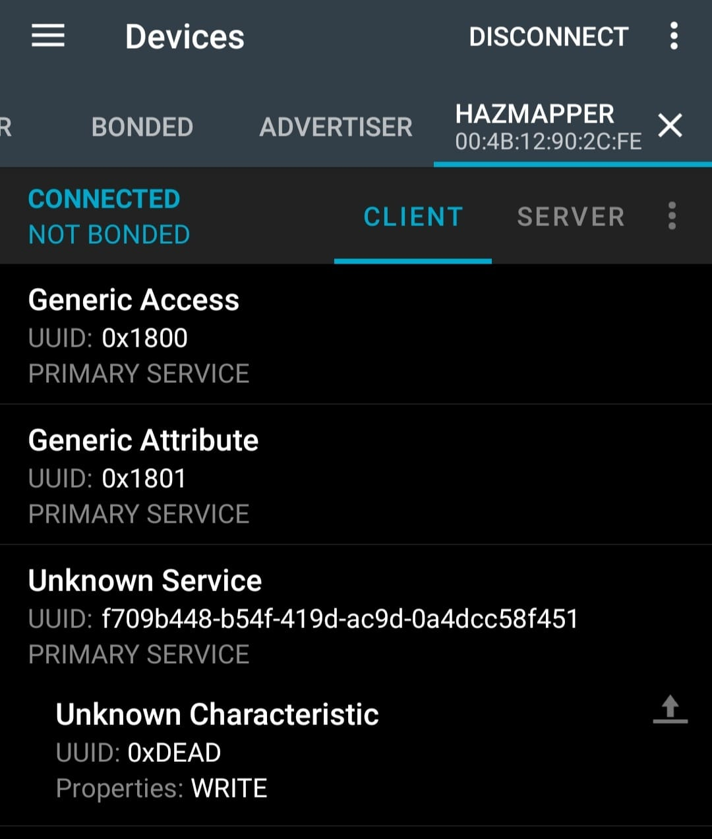
[picture p15: figure]

Fig. 17. Topico GATT para Esrita ´

G. Wi-Fi ESP
Com o intuito de verificar se a conexao Wi-Fi estava ˜ funcional, verificamos no computador se a rede criada pela ESP como AP aparecia (Fig.18).

Fig. 18. Rede Wi-Fi criada pela ESP como AP

De seguida, conectamo-nos a essa rede e verificamos,
atraves de um script ´ | python, direcionado para a porta UDP
configurada na ESP, se estavamos a receber dados de teste ´ enviados pela ESP atraves de um socket UDP, tal como ´ demonstra a figura 19.

VII. DESVIOS DA IDEIA INICIAL
Inicialmente, um dos grandes objetivos era ter implementado um digital-twin que replicava os movimentos do robo em ˆ
ROS2. Contudo, devido a restriçoes de tempo, n ˜ | ao foi poss ˜ | ível
te-lo totalmente implementado ˆ | a data da entrega do relat ` | orio, ´
apesar de ter iniciado algum trabalho (Anexo X-J).

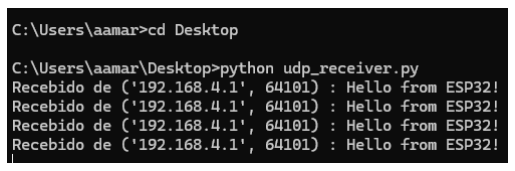
[picture p16: figure]

Fig. 19. Receçao Mensagens UDP ˜

VIII. TRABALHO FUTURO
- Conseguir replicar os movimentos do robo utilizando o ˆ ROS2 no computador e µROS na STM (Anexo X-J;
- Implementaçao de ROS2 e ˜ | µROS para conseguir produzir
um digital-twin no robo no computador; ˆ
- Implementaçao de um servidor HTTP MJPEG atrav ˜ | es do ´
Wi-Fi ESP com o intuito de reproduzir a imagem enviada pela enviada (Anexo X-I);
- Implementaçao de m ˜ | odulo de GPS para analisar a ´
localizaçao exata onde foram registados os dados; ˜
- Implementaçao de m ˜ | odulos de comunicaç ´ | ao por ra- ˜
diofrequencia a longa dist ˆ | ancia ( ˆ | LoRa);
- Implementaçao de microcontrolador com interface mul- ˜ timedia com maior capacidade (Raspberry Pi). ´

IX. CONCLUSAÕ

O desenvolvimento deste robo teve como principal objetivo ˆ criar uma soluçao capaz de se deslocar em ambientes poten- ˜
cialmente perigosos, recolhendo informaçao relevante atrav ˜ | es´
de sensores e comunicando-a de forma remota. Ao longo do projeto, foi possível integrar varias tecnologias de forma ´ funcional: o ESP32 garantiu nao s ˜ o o controlo via Bluetooth ´ BLE, facilitando a interaçao direta com o utilizador, como ˜
tambem a recolha e envio de dados atrav ´ | es de Wi-Fi. A ´ | STM32
ficou responsavel por toda a interface direta com o rob ´ | o e os ˆ
modulos integrados. ´
Foram adicionados sensores de temperatura, gas e estaciona- ´ mento, que ajudam o robo a perceber melhor o ambiente e ˆ
aumentam a segurança durante a navegaçao. A inclus ˜ | ao de ˜
rodas omnidirecionais revelou-se bastante util, pois permite ´
uma movimentaçao precisa, algo que ˜ | e muito vantajoso em ´
espaços mais apertados. Tambem foi feita a ligaç ´ | ao a um ˜
modulo de c ´ | amara, com vista a permitir, no futuro, a criaç ˆ | aõ
de mapas visuais das areas percorridas. A monitorizaç ´ | ao do ˜
estado da bateria garantiu maior fiabilidade ao sistema.
No geral, o projeto atingiu a maioria dos objetivos propos-
tos, demonstrando que e poss ´ | ível combinar diferentes modulos ´
e microcontroladores para criar uma plataforma movel vers ´ | atil, ´
estando sempre cientes da suas limitaçoes. Apesar disso, e ˜ como ja referido, ficaram identificadas algumas melhorias ´ possíveis para implementaçao futura. ˜

X. ANEXOS
A. Analise- Diagrama de Use-Case ´

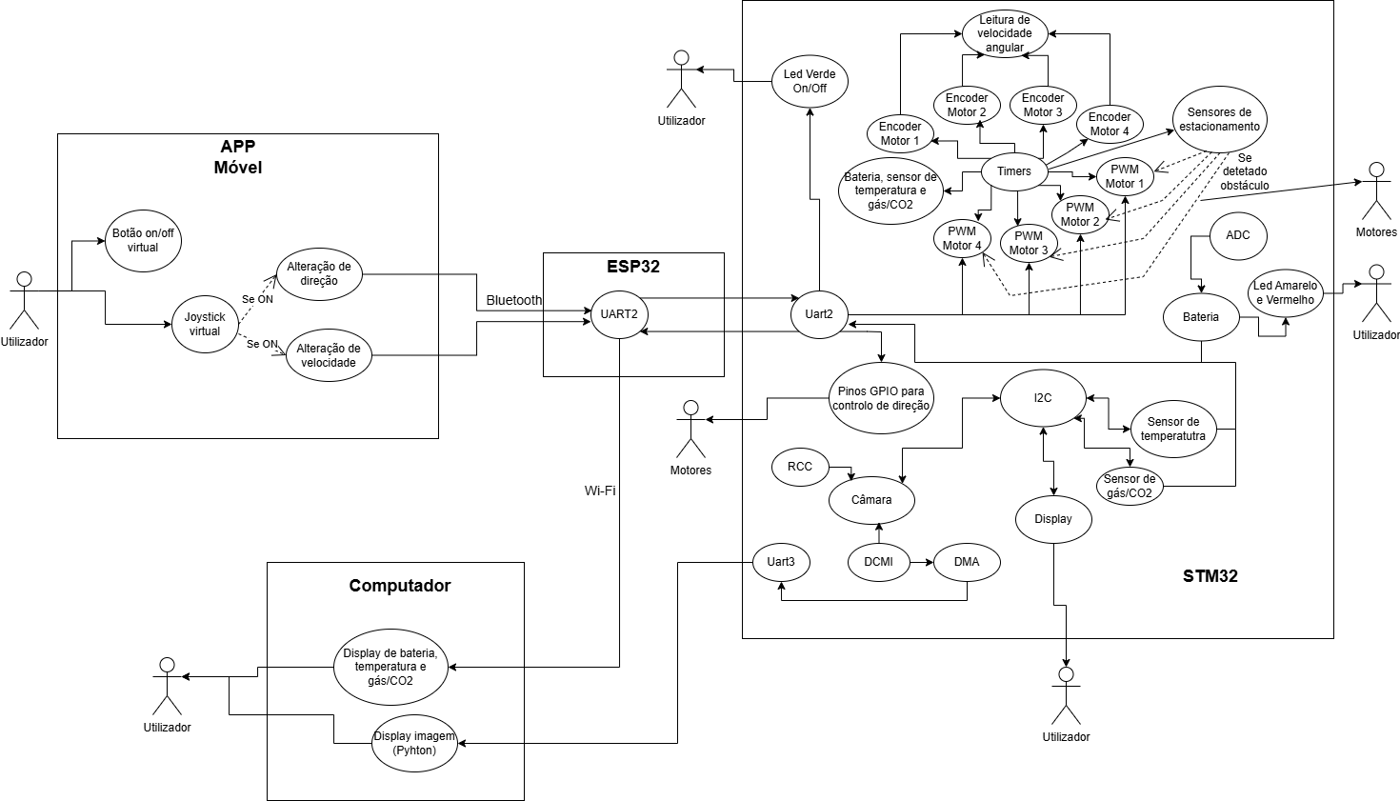
[picture p17: figure]

Fig. 20. Diagrama de Use-Case

11

B. Controlo da Ponte-H
Para o controlo dos motores de corrente contínua utilizados no robo HazMapper, recorreu-se ˆ | a utilizaç ` | ao de pontes H do ˜
tipo L298N. Este circuito integrado permite comandar motores DC em ambos os sentidos de rotaçao, atrav ˜ | es do controlo de ´
dois sinais digitais de entrada por motor. O L298N possui dois canais, o que permite controlar dois motores com um unico ´ modulo. ´
No sistema desenvolvido, foram utilizadas duas placas L298N, uma para cada par de motores (frontal e traseiro), garantindo
assim controlo independente de cada roda. A direçao de rotaç ˜ | ao de cada motor ˜ | e determinada pela combinaç ´ | ao l ˜ | ogica dos ´
sinais de entrada, conforme ilustrado nas Tabelas III e IV.
Alem do controlo da direç ´ | ao, a velocidade dos motores ˜ | e ajustada atrav ´ | es da modulaç ´ | ao por largura de impulso (PWM), ˜
aplicada ao terminal de ativaçao do L298 (ENA ou ENB), permitindo um controlo suave e preciso da locomoç ˜ | ao do rob ˜ | o.ˆ
In1 | In2 | VOut1 − VOut2
1 | 1 | 0
0 | 0 | 0
0 | 1 | REVERSE
1 | 0 | FORWARD
TABLE III
SENTIDOS DE ROTAÇ AO PARA OS VALORES DE ˜ | IN1 E IN2
In3 | In4 | VOut4 − VOut3
1 | 1 | 0
0 | 0 | 0
0 | 1 | REVERSE
1 | 0 | FORWARD
TABLE IV
SENTIDOS DE ROTAÇ AO PARA OS VALORES DE ˜ | IN3 E IN4
C. Controlo em malha fechada

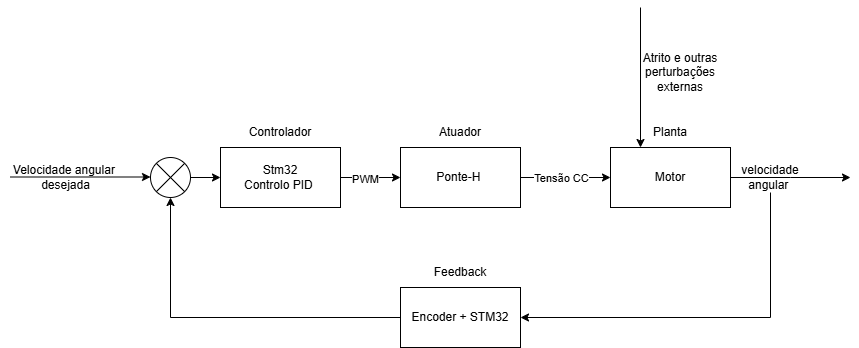
[picture p18: figure]

Fig. 21. Esquematico do sistema em malha fechada ´

D. Sensores de Ultrassom
O modulo da Figura 22 ´ | e o m ´ | odulo que vem com os sensores quando s ´ | ao comprados e onde se conecta a alimentaç ˜ | ao dos ˜
sensores, (conector JST vermelho), os dados recebidos e os varios sensores. ´
Atraves da an ´ | alise da Figura 23 conseguimos ver a informaç ´ | ao enviada pelo m ˜ | odulo dos sensores no momento em que um ´
dos sensores esta a detetar obst ´ | aculos. Vemos o Start Bit, o Sync Bit (identificado como ” ´ | nd”) e reparamos que os primeiros 8
bits enviados a seguir ao bit de sincronizaçao n ˜ | ao t ˜ | em todos o mesmo ˆ | duty-cycle. Apos an ´ | alise em v ´ | arias frames, concluimos ´
que bits com duty-cycle menor (≈ 30%) equivalem a um bit com valor logico 0 e bits com ´ | duty-cycle maior (≈ 60%) equivalem
a um bit com valor logico 1. Portanto, o valor recebido nesta frame, para o primeiro sensor foi 3, em decimal, o que indica a ´
deteçao de um obst ˜ | aculo a uma dist ´ | ancia compreendida entre 0.3m e 0.4m na direç ˜ | ao do sensor. ˜

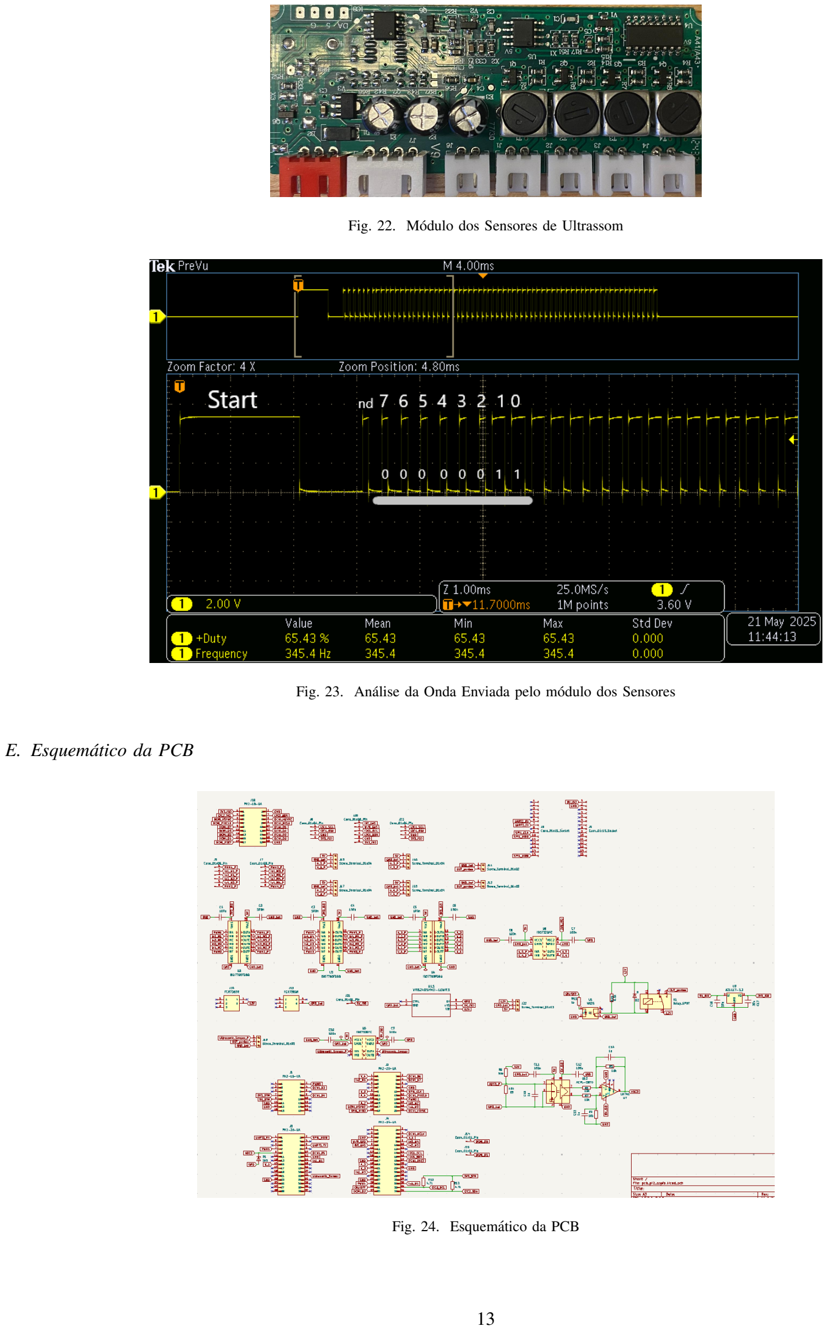
[picture p19: page 13]

Fig. 22. Modulo dos Sensores de Ultrassom ´

Fig. 23. Analise da Onda Enviada pelo m ´ | odulo dos Sensores ´
E. Esquematico da PCB ´

Fig. 24. Esquematico da PCB ´

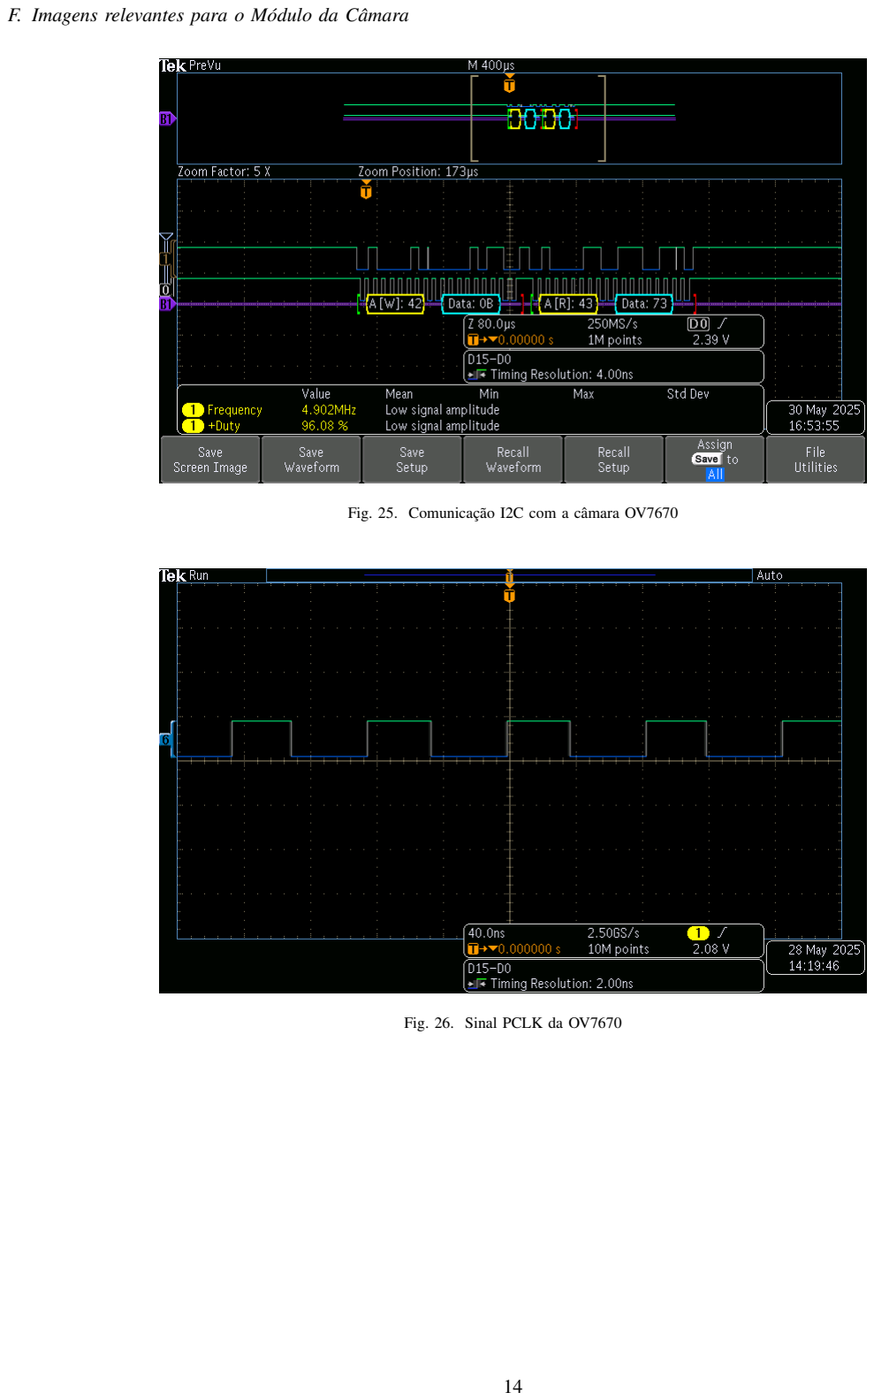
[picture p20: page 14]

F. Imagens relevantes para o Modulo da C ´ | amara ˆ
Fig. 25. Comunicaçao I2C com a c ˜ | amara OV7670 ˆ

Fig. 26. Sinal PCLK da OV7670

G. Equaçoes para o c ˜ | alculo dos par ´ | ametros do Motor ˆ
"
| | dω(t) dt dθ(t) dt #
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
1 | 0 # "ω(t)
| θ(t)
+

"
KmKw
RJ

1
J
0 | 0# " u(t)
| md(t)
(7)
"
ω(t)
θ(t)
=

"
1 0

0 1# "ω(t)

θ(t)

(8)

J =

1
2

mr²
(9)
ua(t) = R · ia(t) + Km · ω(t) | (10)

B =

mm ωss | (11)

H. Organizaçao do Sistema implementado com FreeRTOS ˜

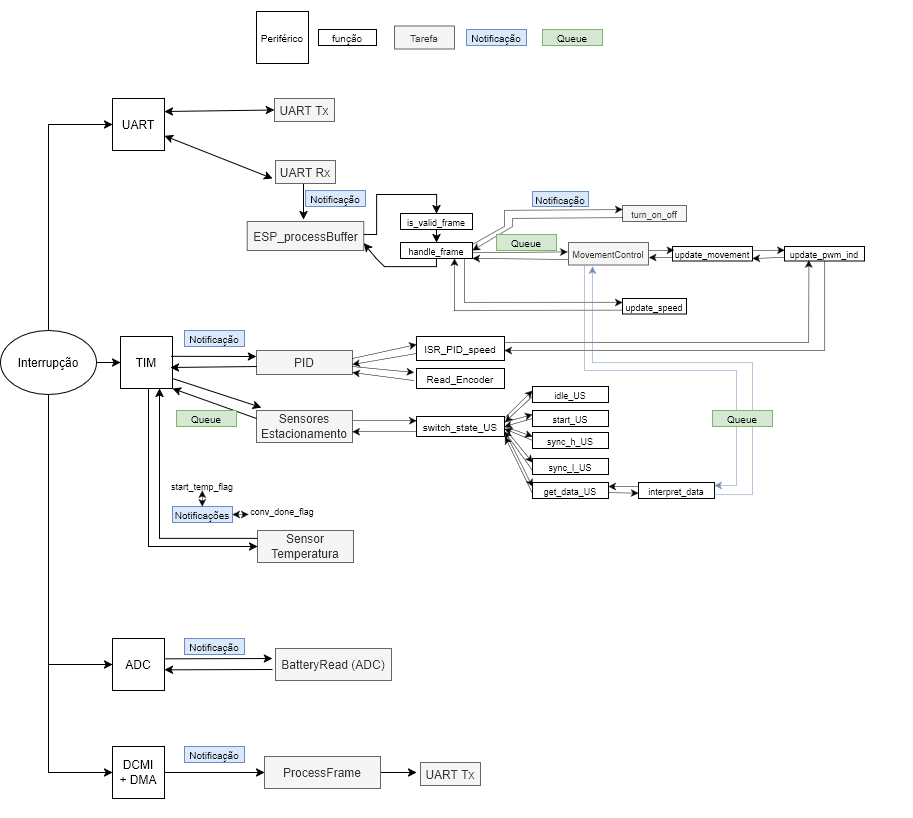
[picture p21: figure]

Fig. 27. Organizaçao do Sistema implementado com FreeRTOS ˜

I. Servidor HTTP MJPEG

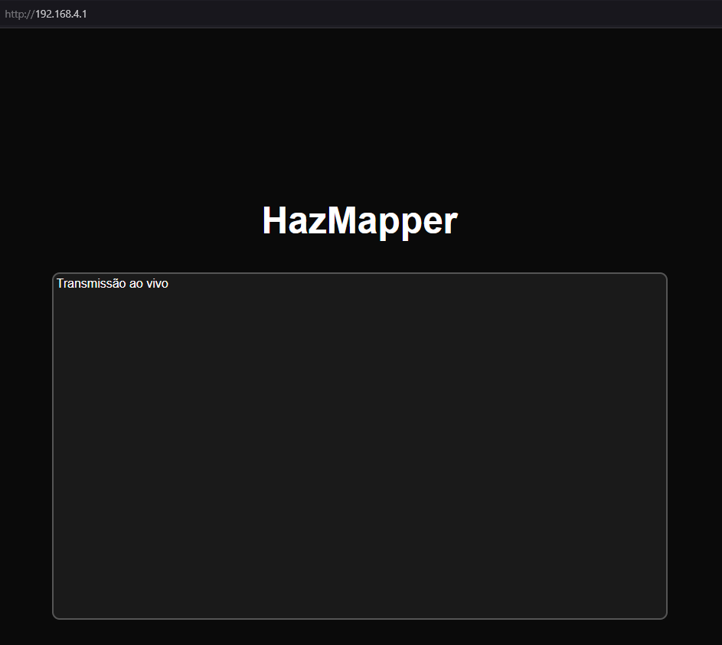
[picture p22: figure]

Fig. 28. Servidor HTTP criado

Foi criado um servidor HTTP MJPEG para transmissao em tempo real de imagens JPEG enviadas pela ˜ | STM e recebidas pela
ESP. O intuito principal seria receber as imagens no formato RGB565 na ESP e converte-las para JPEG. Esta imagem seria ˆ
posteriormente transmitida, frame a frame, atraves de um servidor HTTP MJPEG designado para o efeito. ´ | A data de entrega, `
o servidor estava montado (Figura 28) no endereço 192.168.4.1 (endereço Wi-Fi da ESP), contudo nao foi poss ˜ | ível realizar o
teste. Os resultados previstos seriam uma transmissao com alguma lat ˜ | encia relativamente ˆ | a realidade devido ` | as limitaç ` | oes do ˜
hardware, contudo, com uma implementaçao do tipo ˜ | header e footer para envio e receçao de imagem, seria poss ˜ | ível garantir
um jitter constante e relativamente baixo.
J. Integraçao do micro-ROS com STM32H755 para simulaç ˜ | ao de Digital Twin ˜

O sistema desenvolvido tem como objetivo controlar os movimentos da tartaruga no simulador turtlesim, utilizando os
dados de direçao gerados pelo rob ˜ | o f ˆ ísico. Para tal, foi utilizada a tecnologia ROS2 (Robot Operating System 2), que permite
comunicaçao modular entre diferentes componentes atrav ˜ | es de ´ | nos´ , topicos ´ | e mensagens.
O ROS2 e um middleware amplamente utilizado em sistemas rob ´ | oticos modernos, permitindo a interligaç ´ | ao entre m ˜ | odulos ´
de forma distribuída e eficiente. Um dos simuladores frequentemente utilizados para testes e aprendizagem e o ´ | turtlesim, que
simula o movimento de uma tartaruga em duas dimensoes. ˜
O movimento da tartaruga e controlado atrav ´ | es do t ´ | opico ´ | /turtle1/cmd_vel, que recebe mensagens do tipo
geometry_msgs/msg/Twist. Estas mensagens contem dois vetores: ˆ | linear e angular, ambos com tres componentes ˆ
(x, y, z). Para este projeto, apenas o vetor linear sera utilizado, especificamente os eixos ´ | x e y, para definir a direçao da ˜
tartaruga no plano 2D.
Como o nucleo ´ | M4 do microcontrolador STM32H755 nao possui capacidades de comunicaç ˜ | ao por Wi-Fi, foi necess ˜ | ario ´
utilizar o micro-ROS, uma versao compacta do ROS2 desenhada para correr em microcontroladores com recursos limitados. ˜
O micro-ROS e respons ´ | avel por criar o n ´ | o que publica os dados no t ´ | opico ´ | /turtle1/cmd_vel.
Contudo, o micro-ROS nao comunica diretamente com o ROS2. Para isso, ˜ | e necess ´ | ario utilizar um ´ | micro-ROS Agent,
que atua como intermediario entre o microcontrolador e a rede ROS2. Foi utilizada a ´ | ESP32, anteriormente mencionada, como
dispositivo intermediario entre o ´ | core M4 (onde corre o micro-ROS, em cima do freeRTOS) e o ROS2. A ESP32 corre o
micro-ROS Agent, que recebe os dados do micro-ROS via UART e os transmite para a rede Wi-Fi, ligando-se ao ROS2 que corre num computador host.
A arquitetura de comunicaçao pode ser representada da seguinte forma: ˜
Para garantir uma comunicaçao eficiente entre os dois n ˜ | ucleos (Cortex-M7 e Cortex-M4) da ´ | STM32, optou-se pela utilizaçaõ
do periferico IPCC (Inter-Processor Communication Controller). Este m ´ | odulo permite a troca de sinais e mensagens entre os ´
nucleos de forma r ´ | apida e sincronizada, sem risco de acesso concorrente ´ | a mem ` | oria. ´

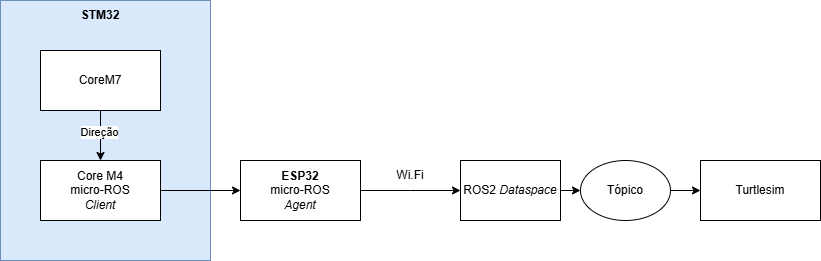
[picture p23: figure]

Fig. 29. Sistema com micro-ROS e Turtlesim

Neste projeto, o nucleo M7 recebe comandos de direç ´ | ao (por exemplo, da ESP32) e atualiza uma ˜
variavel partilhada numa regi ´ | ao comum de mem ˜ | oria (SRAM4). Ap ´ | os atualizar a direç ´ | ao, o M7 utiliza ˜
o IPCC para notificar o nucleo M4 de que h ´ | a uma nova direç ´ | ao dispon ˜ | ível. O M4, que corre o
micro-ROS, e ativado por esta interrupç ´ | ao e l ˜ | e a nova direç ˆ | ao, convertendo-a numa mensagem do tipo ˜
geometrymsgs/msg/T wistqueeent ´ | aopublicadanot ˜ | opico/turtle ´ | 1/cmdvel, controlandoassimomovimentodatartaruganosimulador.
Os comandos enviados seguem a estrutura da mensagem Twist, para cada movimento respetivo:
- Frente: {linear: {x: 0.0, y: 1.0, z: 0.0}, angular: {x: 0.0, y: 0.0, z: 0.0}}
- Tras: ´ {linear: {x: 0.0, y: -1.0, z: 0.0}, angular: {x: 0.0, y: 0.0, z: 0.0}}
- Direita: {linear: {x: 1.0, y: 0.0, z: 0.0}, angular: {x: 0.0, y: 0.0, z: 0.0}}
- Esquerda: {linear: {x: -1.0, y: 0.0, z: 0.0}, angular: {x: 0.0, y: 0.0, z: 0.0}}
- Diagonal Frente-Esquerda: {linear: {x: 1.0, y: 1.0, z: 0.0}, angular: {x: 0.0, y: 0.0, z: 0.0}}
- Diagonal Frente-Direita: {linear: {x: 1.0, y: -1.0, z: 0.0}, angular: {x: 0.0, y: 0.0, z: 0.0}}
- Diagonal Tras-Esquerda: ´ | {linear: {x: -1.0, y: 1.0, z: 0.0}, angular: {x: 0.0, y: 0.0, z:
0.0}}
- Diagonal | Tras-Direita: ´ | {linear: {x: -1.0, y: -1.0, z: 0.0}, angular: {x: 0.0, y: 0.0, z:
0.0}}
Com base na direçao recebida, a tartaruga move-se no plano, assumindo que est ˜ | a inicialmente orientada com a cabeça para ´
cima (eixo positivo do eixo Y). No lado do ROS2, e poss ´ | ível implementar um no em C++ que subscreve aos dados enviados pela ´
ESP32. Este no recebe os comandos publicados, processa-os e apresenta-os no terminal para verificaç ´ | ao. Posteriormente, esta ˜
funcionalidade pode ser expandida para incluir açoes mais complexas, como controlar outros dispositivos, realizar processamento ˜ adicional ou interagir com outros nos do sistema. ´
| | XI. REFERENCIAS ˆ

Datasheet STM32H755, STMicroelectronics.
Reference Manual STM32H755, STMicroelectronics. User Manual STM32H755, STMicroelectronics. Application Notes para STM32H755, STMicroelectronics. Datasheet ESP32 Series, Espressif.
Technical Reference Manual ESP32, Espressif. Espressif Github: https://github.com/espressif.
Guia 2, PI2, LEEIC UM, 3º ano.
Datasheet L298, STMicroelectronics. Datasheet PMODHYGRO, Digilent.
Datasheet PMODAQS, Digilent.
Datasheet OV7670, OmniVision.
Datasheet Display LCD com interface I2C, CYPRESS.

Kotlin and Android, Android Developers
µROS: https://micro.ros.org/
ROS2: https://docs.ros.org/en/humble/Tutorials.html
