andrem20/HazMapper/Code/CM7/Core/Src/main.c

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
/* Includes ------------------------------------------------------------------*/
#include "main.h"
#include "cmsis_os.h"
#include "adc.h"
#include "dcmi.h"
#include "dma.h"
#include "i2c.h"
#include "spi.h"
#include "tim.h"
#include "usart.h"
#include "gpio.h"

/* USER CODE BEGIN Includes */
#include "DD_MotorControl.h"
#include "usart_support.h"
#include "movement_control.h"
#include "battery.h"
#include "esp_driver.h"
#include "UltrasonicSensors.h"
#include "camera.h"
/* USER CODE END Includes */

/* USER CODE BEGIN PD */

#ifndef HSEM_ID_0
#define HSEM_ID_0 (0U) /* HW semaphore 0*/
#endif

/* USER CODE END PD */

/* USER CODE BEGIN PM */
#define MSG_SIZE 32
/* USER CODE END PM */


/* USER CODE BEGIN PV */
volatile uint8_t received = 0;
volatile uint8_t msg_ready = 0;

volatile uint8_t frame_buffer_A[FRAME_BUFFER_SIZE];
volatile uint8_t frame_buffer_B[FRAME_BUFFER_SIZE];
volatile uint8_t *current_dcmi_ptr;
volatile uint8_t *uart_pending_ptr;

/* USER CODE END PV */

void SystemClock_Config(void);
void MX_FREERTOS_Init(void);
/**
  * @brief  The application entry point.
  * @retval int
  */
int main(void)
{

/* USER CODE BEGIN Boot_Mode_Sequence_0 */
	int32_t timeout;
/* USER CODE END Boot_Mode_Sequence_0 */

/* USER CODE BEGIN Boot_Mode_Sequence_1 */
	/* Wait until CPU2 boots and enters in stop mode or timeout*/
	timeout = 0xFFFF;
	while((__HAL_RCC_GET_FLAG(RCC_FLAG_D2CKRDY) != RESET) && (timeout-- > 0));
	if ( timeout < 0 )
	{
		Error_Handler();
	}
/* USER CODE END Boot_Mode_Sequence_1 */
  /* MCU Configuration--------------------------------------------------------*/

  /* Reset of all peripherals, Initializes the Flash interface and the Systick. */
  HAL_Init();

  /* Configure the system clock */
  SystemClock_Config();
/* USER CODE BEGIN Boot_Mode_Sequence_2 */
	/* When system initialization is finished, Cortex-M7 will release Cortex-M4 by means of
HSEM notification */
	/*HW semaphore Clock enable*/
	__HAL_RCC_HSEM_CLK_ENABLE();
	/*Take HSEM */
	HAL_HSEM_FastTake(HSEM_ID_0);
	/*Release HSEM in order to notify the CPU2(CM4)*/
	HAL_HSEM_Release(HSEM_ID_0,0);
	/* wait until CPU2 wakes up from stop mode */
	timeout = 0xFFFF;
	while((__HAL_RCC_GET_FLAG(RCC_FLAG_D2CKRDY) == RESET) && (timeout-- > 0));
	if ( timeout < 0 )
	{
		Error_Handler();
	}
/* USER CODE END Boot_Mode_Sequence_2 */

  /* Initialize all configured peripherals */
  MX_GPIO_Init();
  MX_DMA_Init();
  MX_TIM4_Init();
  MX_TIM7_Init();
  MX_USART3_UART_Init();
  MX_I2C1_Init();
  MX_TIM6_Init();
  MX_ADC3_Init();
  MX_DCMI_Init();
  MX_I2C2_Init();
  MX_TIM3_Init();
  MX_SPI1_Init();
  MX_USART2_UART_Init();
  MX_TIM1_Init();
  MX_TIM2_Init();
  MX_TIM5_Init();
  MX_TIM8_Init();
  MX_TIM17_Init();
  /* USER CODE BEGIN 2 */

	//init_vkey(&Button,GPIOC,GPIO_PIN_13, &htim16, TIM16);

	set_On_Off(GPIOB, GPIO_PIN_0);
	set_sampling_parameters(&htim7, TIM7, 10);

	set_Ports(1, GPIOE, GPIOB);
	set_Pins(1, GPIO_PIN_2, GPIO_PIN_15);
	set_pid(1, 1, 0.45, 1.1, 0.67);
	set_PWM_parameters(1, &htim3, TIM_CHANNEL_4, 330, 1000);
	set_encoder_parameters(1, &htim1, TIM_CHANNEL_1, TIM_CHANNEL_2);

	set_Ports(2, GPIOD, GPIOD);
	set_Pins(2, GPIO_PIN_14, GPIO_PIN_15);
	set_pid(2, 1, 0.3, 0.6, 0.67);
	set_PWM_parameters(2, &htim3, TIM_CHANNEL_2, 330, 1000);
	set_encoder_parameters(2, &htim2, TIM_CHANNEL_1, TIM_CHANNEL_2);

	set_Ports(3, GPIOD, GPIOE);
	set_Pins(3, GPIO_PIN_11, GPIO_PIN_13);
	set_pid(3, 1.0, 0.35, 0.67, 0.87);
	set_PWM_parameters(3, &htim3, TIM_CHANNEL_3, 330, 1000);
	set_encoder_parameters(3, &htim4, TIM_CHANNEL_1, TIM_CHANNEL_2);

	set_Ports(4, GPIOE, GPIOE);
	set_Pins(4, GPIO_PIN_14, GPIO_PIN_15);
	set_pid(4, 1.0, 0.35, 0.68, 0.67);
	set_PWM_parameters(4, &htim5, TIM_CHANNEL_1, 330, 1000);
	set_encoder_parameters(4, &htim8, TIM_CHANNEL_1, TIM_CHANNEL_2);

	/* Inicialização sensor temperatura */;
	HAL_TIM_Base_Start_IT(&htim6);
	/* Inicialização Bateria */
	//Battery_init();

	/* Initialização comunicação ESP <-> STM32*/
	ESP_init(&huart2);


  /* USER CODE END 2 */

  /* Init scheduler */
  osKernelInitialize();  /* Call init function for freertos objects (in cmsis_os2.c) */
  MX_FREERTOS_Init();

  /* Start scheduler */
  osKernelStart();

  /* We should never get here as control is now taken by the scheduler */

  /* Infinite loop */
  /* USER CODE BEGIN WHILE */
	while (1)
	{
    /* USER CODE END WHILE */

    /* USER CODE BEGIN 3 */

		//ESP_processBuffer();
	//	sensorTEMP_fsm();
		//Battery_process();
		//	switch_state_US();

	}

  /* USER CODE END 3 */
}

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
/**
  * @brief  Period elapsed callback in non blocking mode
  * @note   This function is called  when TIM16 interrupt took place, inside
  * HAL_TIM_IRQHandler(). It makes a direct call to HAL_IncTick() to increment
  * a global variable "uwTick" used as application time base.
  * @param  htim : TIM handle
  * @retval None
  */

/**
  * @brief  This function is executed in case of error occurrence.
  * @retval None
  */
void Error_Handler(void)
{
  /* USER CODE BEGIN Error_Handler_Debug */
	/* User can add his own implementation to report the HAL error return state */
	__disable_irq();
	while (1)
	{
	}
  /* USER CODE END Error_Handler_Debug */
}
#ifdef USE_FULL_ASSERT
/**
  * @brief  Reports the name of the source file and the source line number
  *         where the assert_param error has occurred.
  * @param  file: pointer to the source file name
  * @param  line: assert_param error line source number
  * @retval None
  */
void assert_failed(uint8_t *file, uint32_t line)
{
  /* USER CODE BEGIN 6 */
	/* User can add his own implementation to report the file name and line number,
     ex: printf("Wrong parameters value: file %s on line %d\r\n", file, line) */
  /* USER CODE END 6 */
}
#endif /* USE_FULL_ASSERT */
