andrem20/HazMapper/(notices)

Notices in the files:
Code/CM7/Core/Src/main.c:
Copyright (c) 2025 STMicroelectronics.
All rights reserved.
This software is licensed under terms that can be found in the LICENSE file
